Ironwin-15/PLL/Readme.md

Aim and Objective. To design and implement a PLL-assisted adaptive PWM control scheme
for a Buck/Boost converter capable of maintaining a regulated output voltage by dynamically
adjusting the duty cycle through phase synchronization between the output ripple feedback and
an externally generated reference frequency.
