Ironwin-15/PLL/Abstract/(Ishwin_Kumar)_ABSTRACT.pdf

PLL-Based Closed-Loop Buck/Boost Converter | Abstract

### Design and Analysis of a PLL-Based Closed-Loop Buck/Boost DC–DC Converter with Arduino PWM Control

A Stage-by-Stage Mathematical Framework with Hardware Implementation for Regulated 10 V −→ 5 V Conversion

By Ishwin Kumar (Under Prof. Abhilash Patel)

Keywords: Buck converter, PLL, Phase-locked loop, BJT phase detector, BC547A, 555-timer VCO, Arduino PWM, Closed-loop control, Frequency response, Lead compensator, Voltage regulator

Aim and Objective. To design and implement a PLL-assisted adaptive PWM control scheme for a Buck/Boost converter capable of maintaining a regulated output voltage by dynamically adjusting the duty cycle through phase synchronization between the output ripple feedback and an externally generated reference frequency.

Background and Motivation. Efficient and regulated DC–DC power conversion is a foundational requirement in embedded systems, battery-powered devices, and laboratory power supplies. Conventional open-loop buck converters suffer from output-voltage drift under varying load and line conditions, motivating the need for a robust closed-loop architecture. This work presents the complete design, hardware implementation, and mathematical analysis of a Phase-Locked Loop (PLL)-based buck/boost converter that regulates an input supply of Vin = 10 V to a stable output of Vout = 5 V, delivering a 50% step-down with tight voltage regulation across load transients.

System Architecture. The proposed system integrates six functional stages into a coherent closed-loop topology. The power stage is an N-channel MOSFET-switched buck (or boost) converter driven by a PWM gate signal of duty cycle D = Vout/Vin. The output is sensed through a resistive divider (R1–R2), scaled to a feedback voltage Vfb = Vout ·R2/(R1 +R2). An AC coupling capacitor extracts the switching-ripple component and feeds it to the phase detector, which compares it against the Arduino-generated reference fref . The phase-error voltage VP D = KP D ϕerr drives the VCO, whose output fV CO = f0 + KV CO Vctrl is compared with a sawtooth ramp inside a comparator, producing the PWM signal that closes the loop.

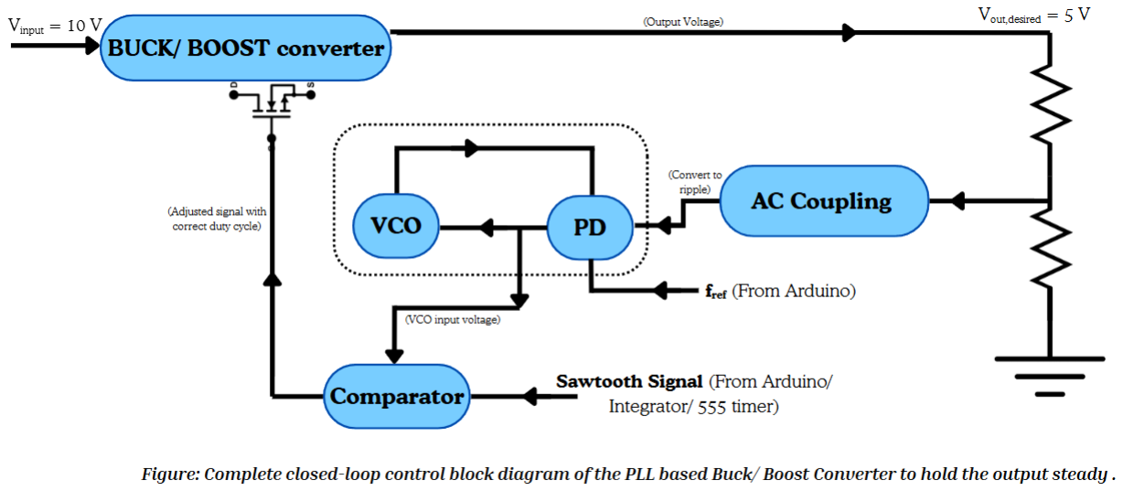
[picture p1: figure]

Figure 1. System Architecture Block Diagram

Work Completed. The following tasks have been completed and are documented with full symbolic derivations and hardware measurements.
(i) PLL Hardware Implementation. The PLL has been fully constructed in hardware. The phase detector is implemented using a BJT-based differential mixer circuit built around the BC547A NPN transistor, whose output is buffered before being fed to the next stage. The VCO is designed around a 555-timer-inspired topology, producing a variable output frequency of up to approximately 500 Hz in response to the PD control voltage. The hardware PD characteristic (output voltage vs. phase difference in degrees) has been measured and curvefitted using Desmos, yielding the sinusoidal regression:
VP D(ϕ) = A sin(Bϕ + C) + D, | A = 1.725, B = 1.058, C = −1.689, D = 2.444, | R² = 0.985

The VCO frequency-vs-voltage characteristic has been measured and confirms excellent linearity, with the linear regression f = m Vctrl + b giving m = 450.25 Hz/V and b = −6.61, R² = 0.998 — establishing the hardware VCO gain as KV CO = 450.25 Hz/V.
(ii) Closed-Loop PLL Analysis and Compensator Design. The complete open-loop transfer function GOL(s) = KP D KV CO F(s)/s has been formulated and analysed using frequency response methods (Bode plots). Natural frequency ωn =

p
KP D KV CO/(RLF CLF ) and damping ratio ζ =

1/2 p
KP D KV CO RLF /CLF were derived and tuned to achieve optimal lock range, pull-in range, and lock time. A compensator has been designed for the loop to meet the required phase margin (≥45) and loop bandwidth (fc ≈ fsw/10), ensuring stable and fast acquisition of lock.
(iii) Buck Converter Design. The basic buck converter stage has been designed to output Vout = 5 V from Vin = 10 V at D = 0.5, with appropriate component sizing and a switching frequency of fsw = 5 kHz via Arduino Timer 1 (ICR1 = 511, OCR1A = 256). The feedback mechanism connecting the PLL output to the MOSFET gate driver — completing the full closed-loop regulation — is not yet implemented and constitutes the primary remaining deliverable.

Experimental Results. Figures 2a and 2b show the hardware characterisation data measured from the built circuit and plotted in Desmos. Figure 2a presents the PD output voltage as a function of input phase difference (in units of radians), with the sinusoidal regression confirming the theoretical KP D ≈ VDD/2π = 1.902 V/rad in theory and matching the fitted amplitude A = 1.725 V. Figure 2b presents the VCO output frequency (Hz) vs. control voltage (V), demonstrating the highly linear KV CO = 450.25 Hz/V characteristic required for predictable PLL behaviour.

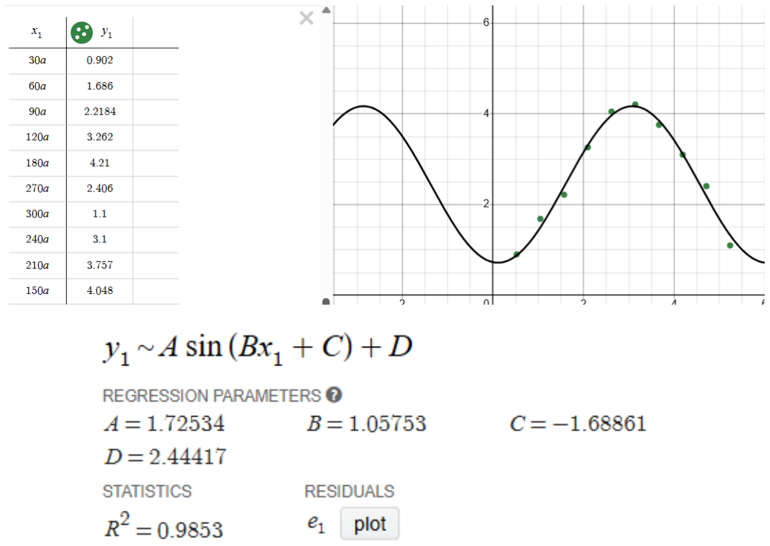
[picture p2: figure]

(a) PD hardware output: VPD vs. phase difference. Fitted curve yields R² = 0.985, KPD = 1.7253 V/rad via sinusoidal fit.

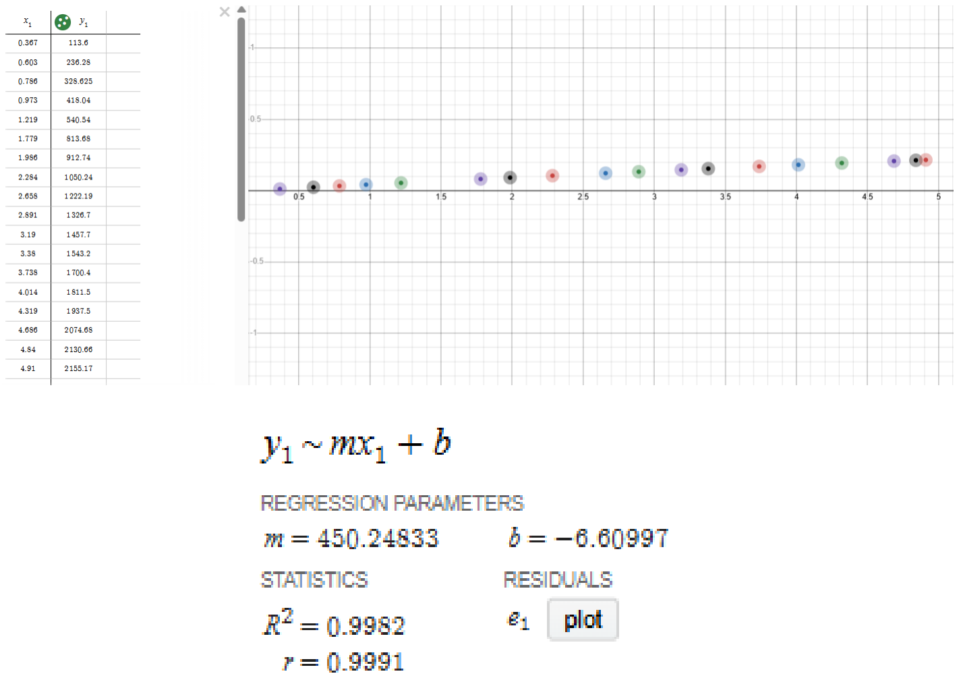
[picture p3: figure]

(b) VCO hardware output: Frequency vs. Vctrl. Fitted curve yields KV CO = 450.25 Hz/V,
f = 450.25V − 6.61, R² = 0.998 via linear fit.

Figure 2. Hardware characterisation plots obtained from the built BC547A phase detector and 555-timer VCO circuit. All regressions were performed in Desmos.

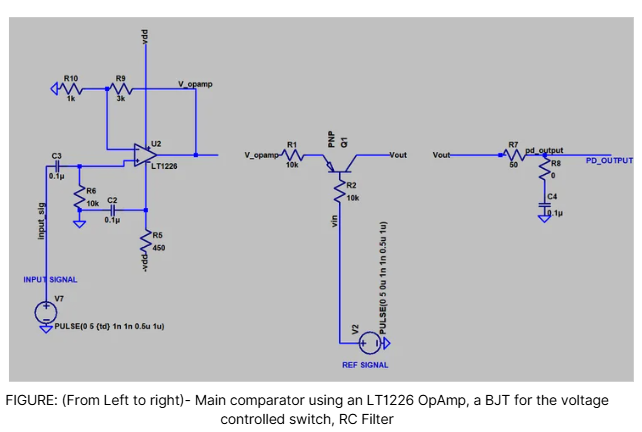
[picture p4: figure]

(a) Phase detector schematic circuit using Bipolar Junction Transistor.

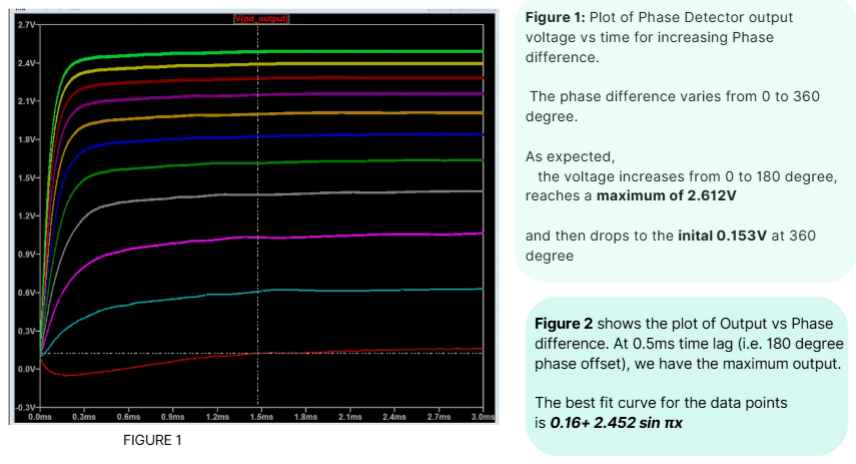
[picture p5: figure]

(b) Phase detector simulated output voltage response vs. increasing phase difference.

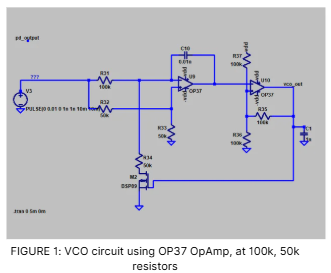
[picture p6: figure]

(a) VCO schematic model and verification using an OP37 OpAmp configuration.

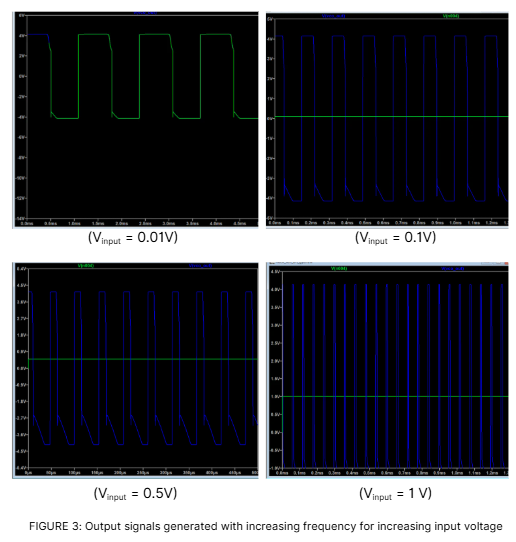
[picture p7: figure]

(b) Increasing output frequencies with increasing input voltage.

Figure 4. LTSpice characterisation plots obtained from the simulated phase detector and VCO circuits.

What This Work Will Demonstrate. The remaining work will close the loop by connecting the PLL output to the buck converter switching MOSFET and demonstrating full closed-loop voltage regulation. Specifically, the following results are targeted: (a) stable Vout = 5.0 ± 0.1 V from 10 V across varying load; (b) oscilloscope verification of D = 50% PWM at the MOSFET gate; (c) PLL lock acquisition waveforms confirming phase detector and VCO hardware operation at the predicted KP D and KV CO values; (d) a completely locked output voltage inspite of fluctuations in the input voltage.

This abstract accompanies the full technical report containing the system block diagram, complete design summary, key waveform plots, compensator design progress, and annotated Arduino firmware. All numerical values correspond to Vin = 10 V, Vout = 5 V, Iout ≤ 1 A, fsw = 5 kHz.
