Ironwin-15/PLL/Boost_Converter/500Hz_output.png

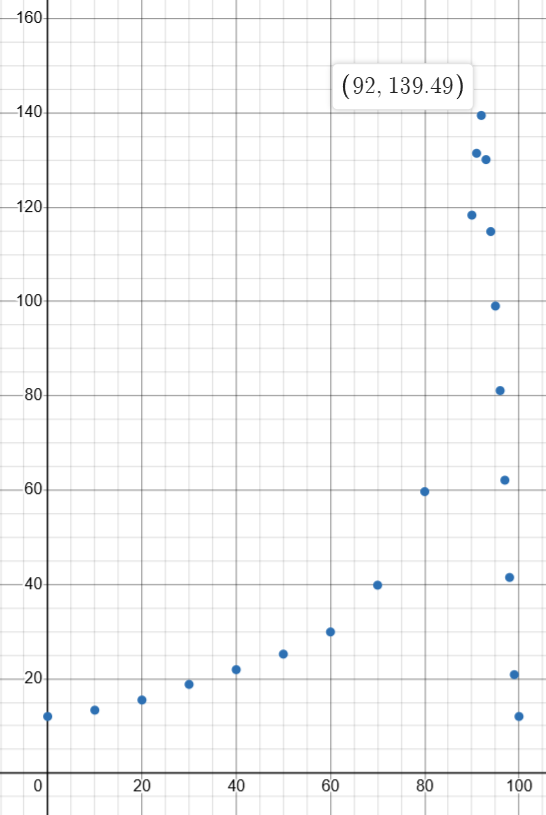
Boost_Converter/500Hz_output.png
