Ironwin-15/PLL/Boost_Converter/COMPENSATED_PLL .png

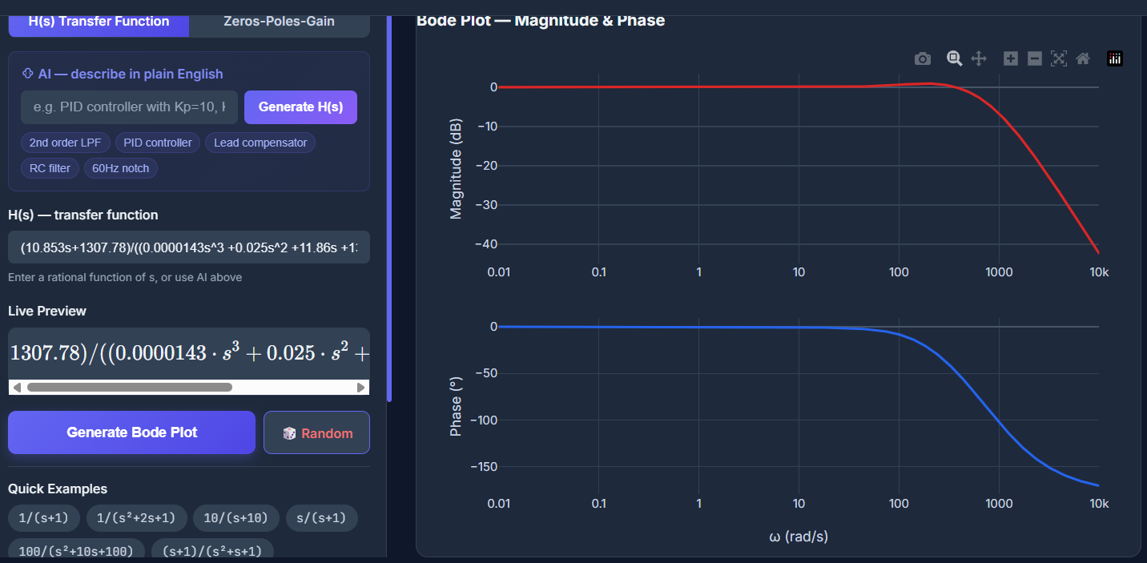
Boost_Converter/COMPENSATED_PLL .png
