Ironwin-15/PLL/Boost_Converter/Phase margin = 128.6.png

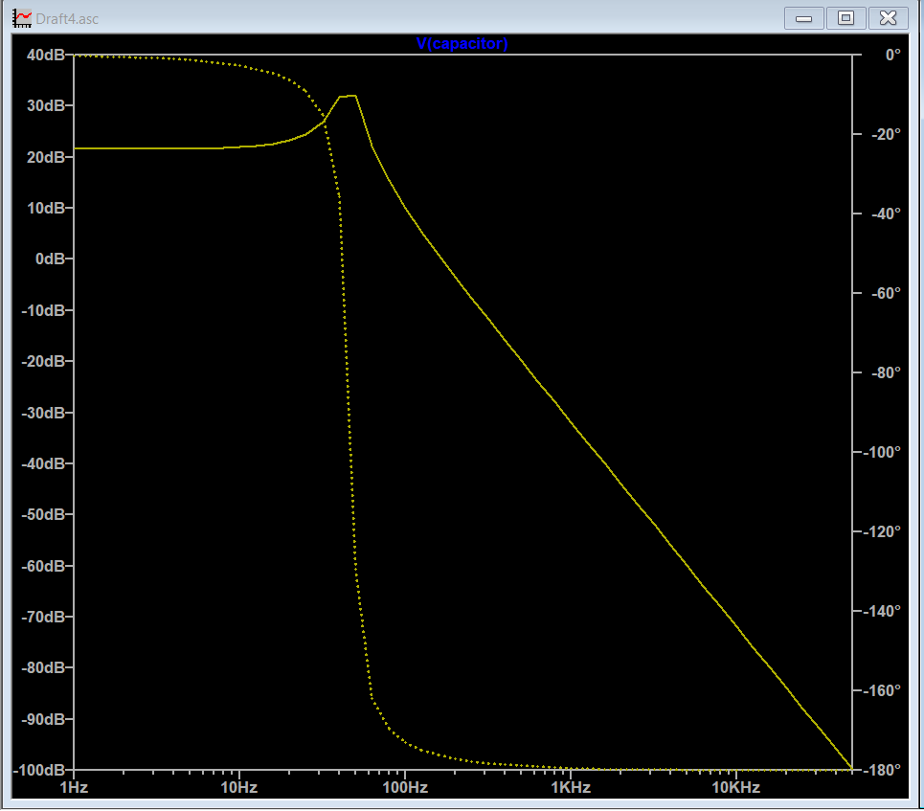
Boost_Converter/Phase margin = 128.6.png
