Ironwin-15/PLL/Boost_Converter/PM=-45) UNCOMPENSATED_BOOST+PLL.png

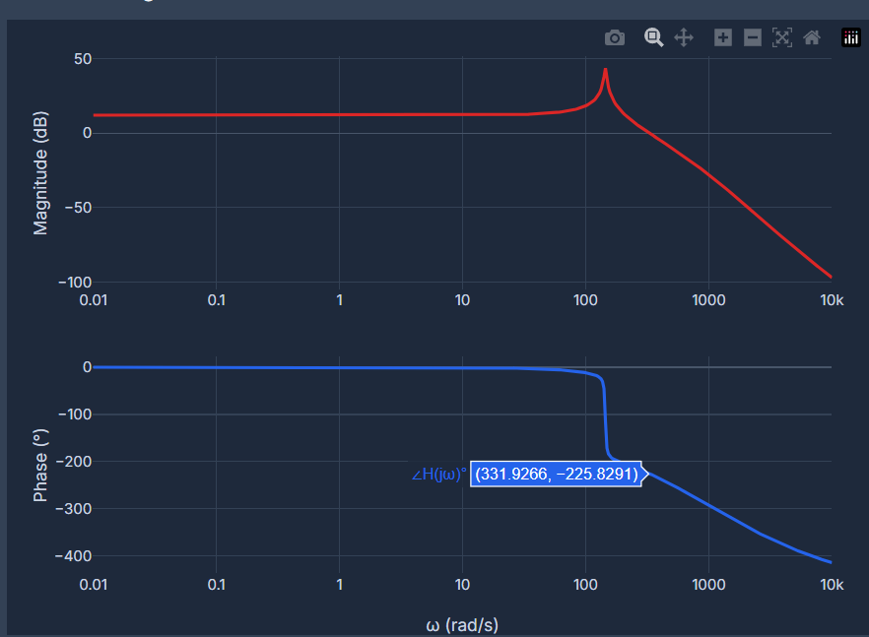
Boost_Converter/PM=-45) UNCOMPENSATED_BOOST+PLL.png
