Ironwin-15/PLL/Boost_Converter/Screenshot 2026-06-19 024352.png

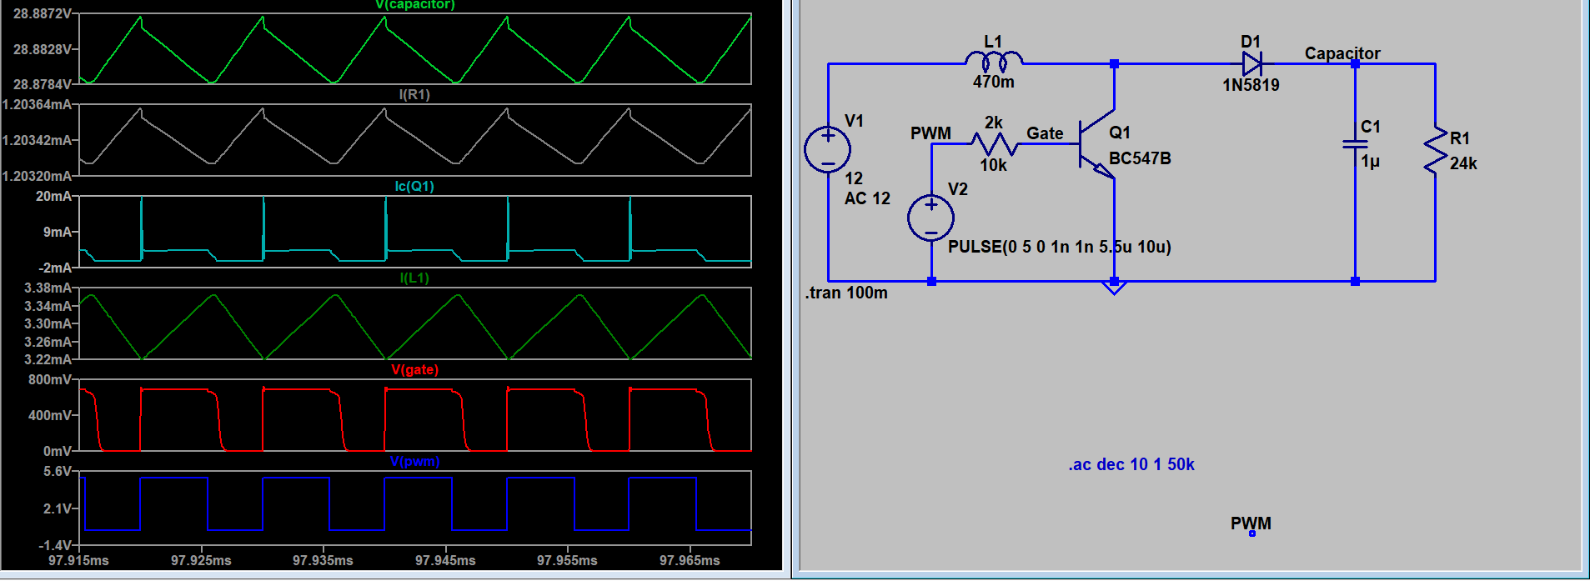
Boost_Converter/Screenshot 2026-06-19 024352.png
