Ironwin-15/PLL/Boost_Converter/theoretical values.png

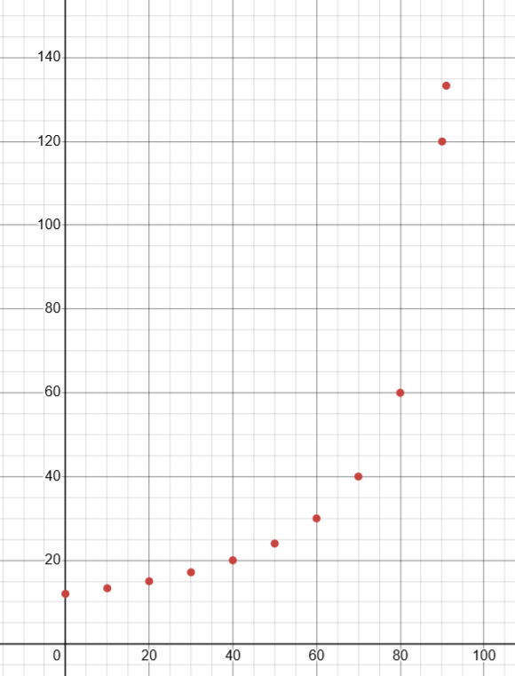
Boost_Converter/theoretical values.png
