Ironwin-15/PLL/Op_Amp Design/Circuit_implementation_of_Phasedetector.png

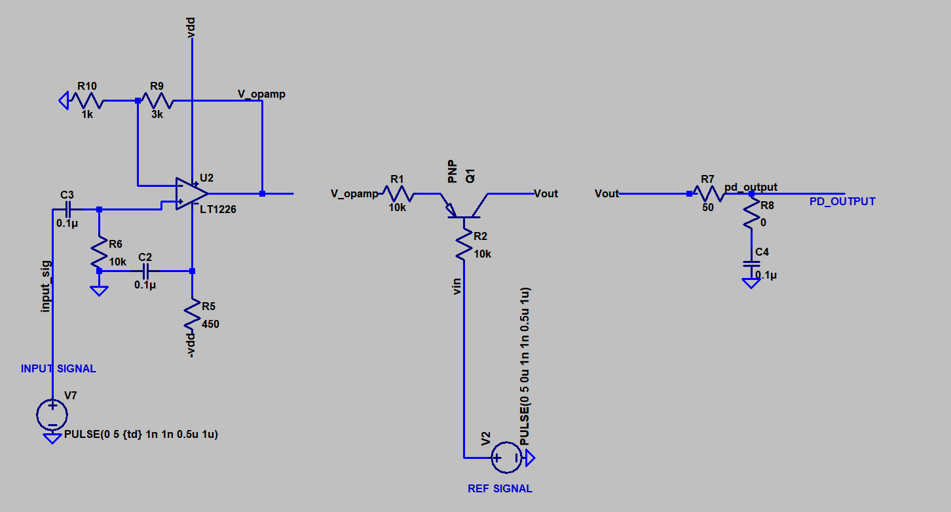
Op_Amp Design/Circuit_implementation_of_Phasedetector.png
