Ironwin-15/PLL/Op_Amp Design/Circuit_of_VCO.png

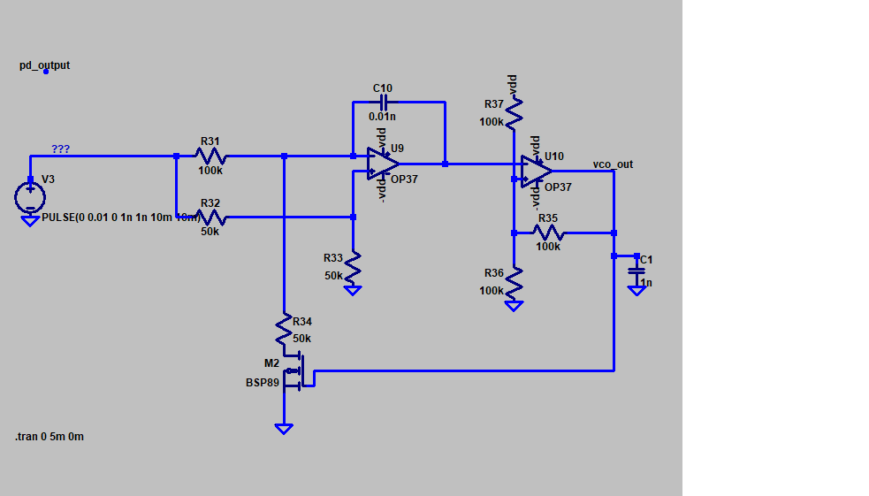
Op_Amp Design/Circuit_of_VCO.png
