Ironwin-15/PLL/Op_Amp Design/Graphs(V_pdout vs timelag)_BJT_SW.png

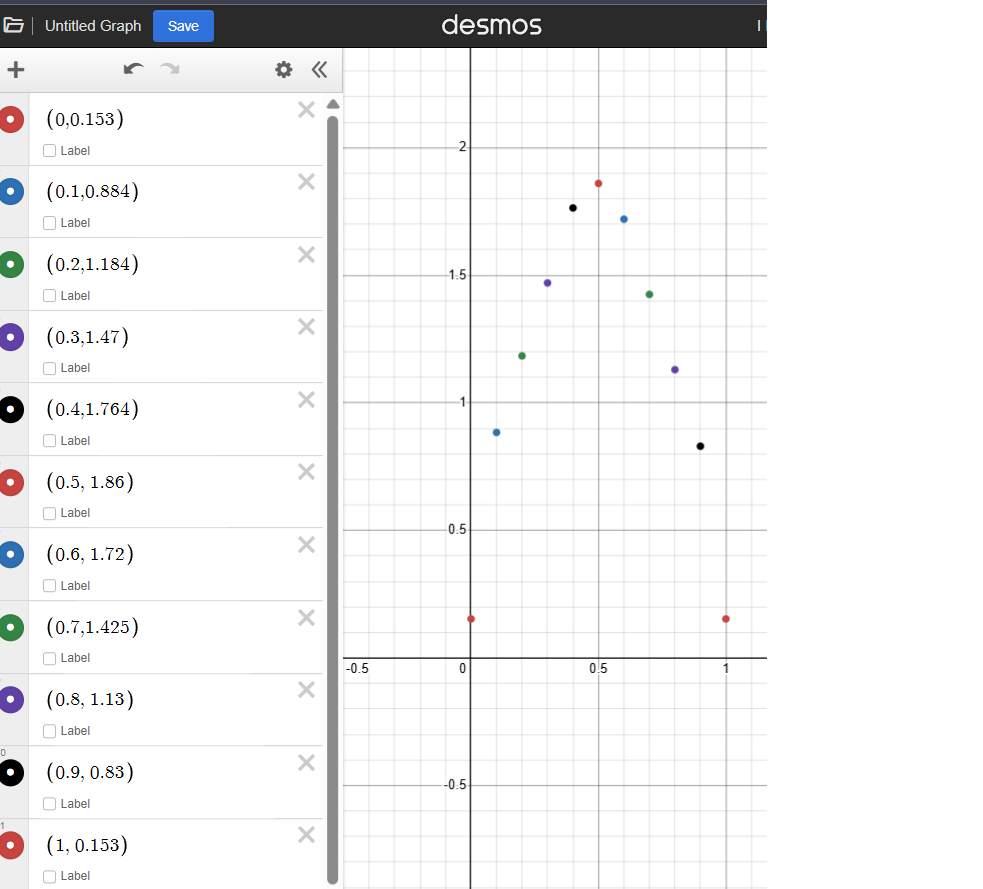
Op_Amp Design/Graphs(V_pdout vs timelag)_BJT_SW.png
