Ironwin-15/PLL/Op_Amp Design/loop_filter.png

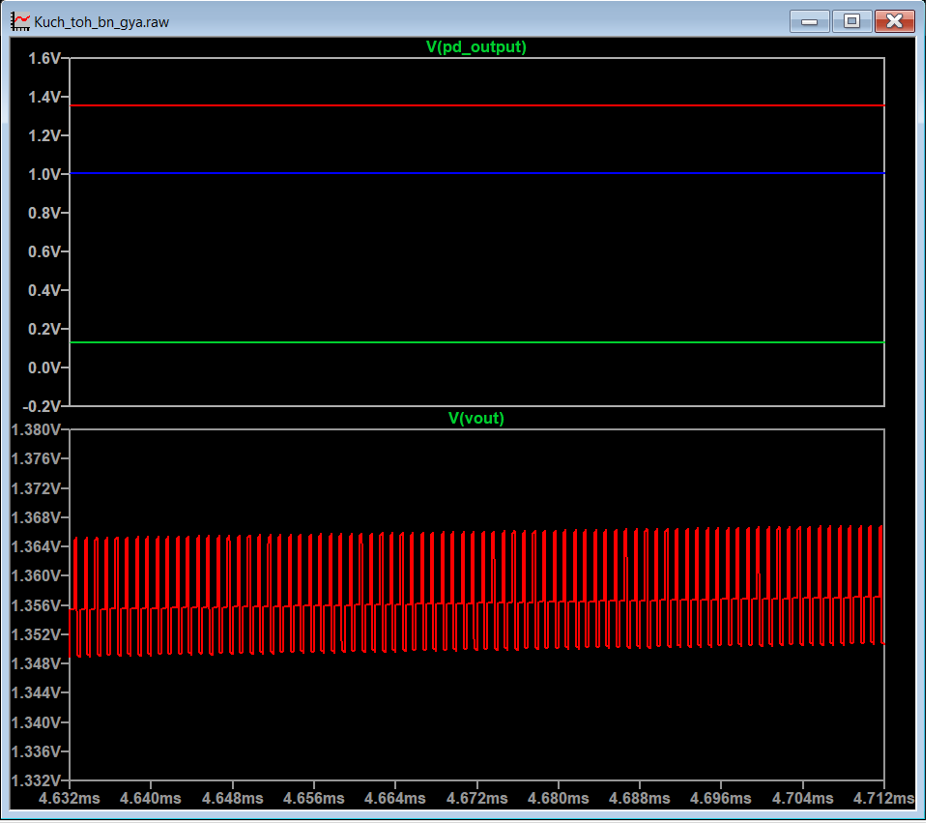
Op_Amp Design/loop_filter.png
