Ironwin-15/PLL/Op_Amp Design/PD_motivation.gif

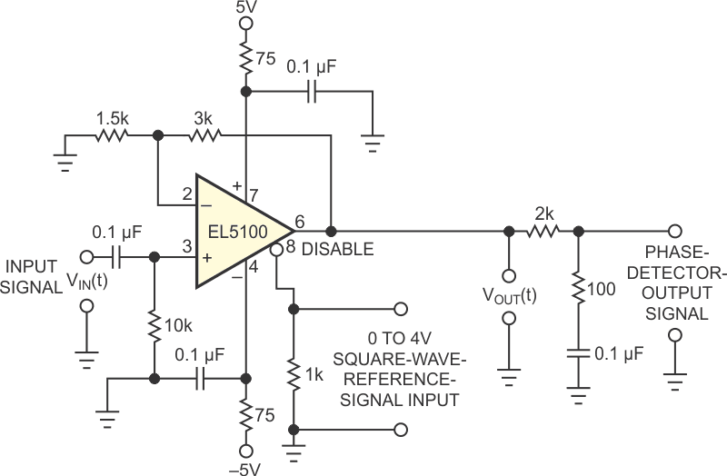
Op_Amp Design/PD_motivation.gif
