Ironwin-15/PLL/Op_Amp Design/pd_output (from time_delay=0u-1u).png

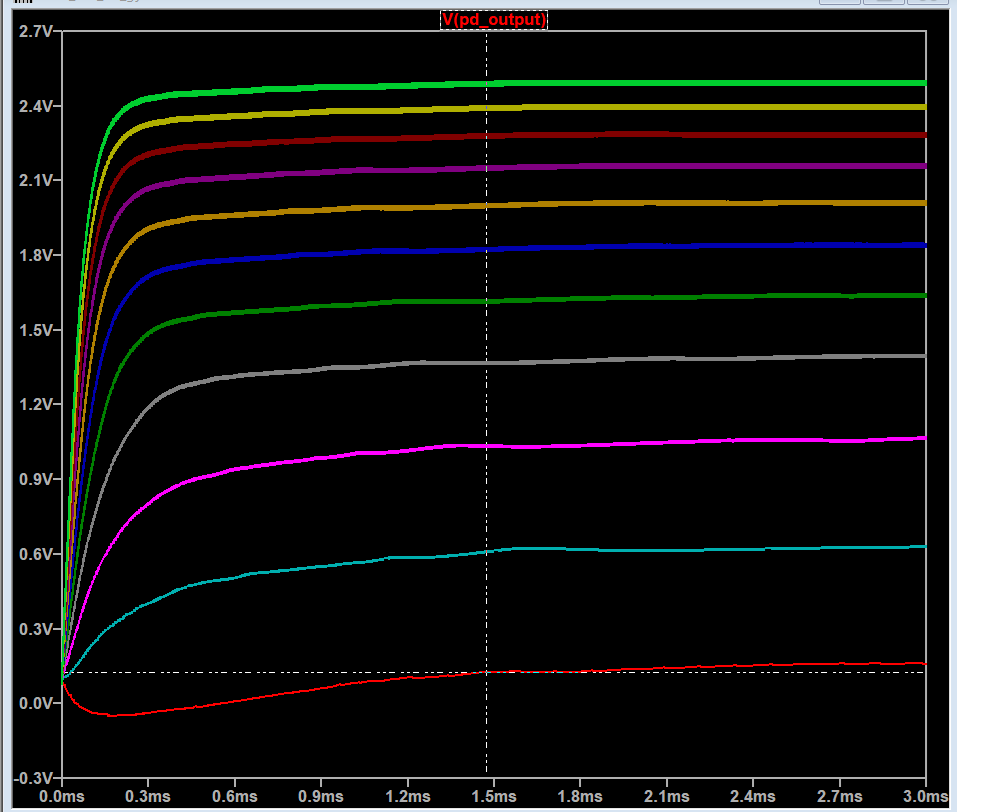
Op_Amp Design/pd_output (from time_delay=0u-1u).png
