Ironwin-15/PLL/Op_Amp Design/VCO output_for_V=0.01V.png

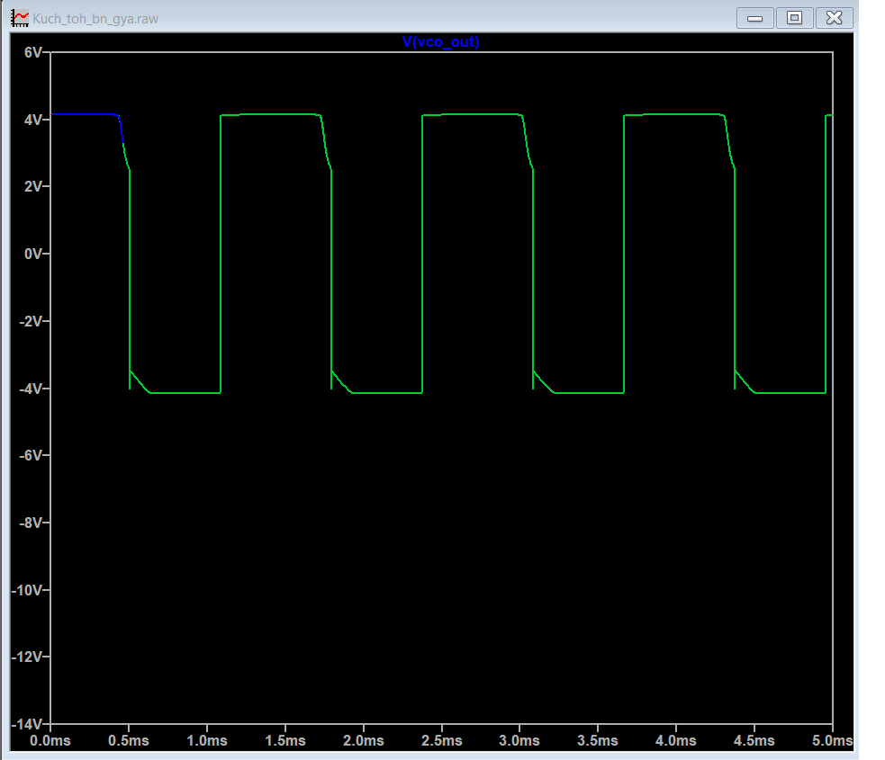
Op_Amp Design/VCO output_for_V=0.01V.png
