Ironwin-15/PLL/Op_Amp Design/VCO output_for_V=1V.png

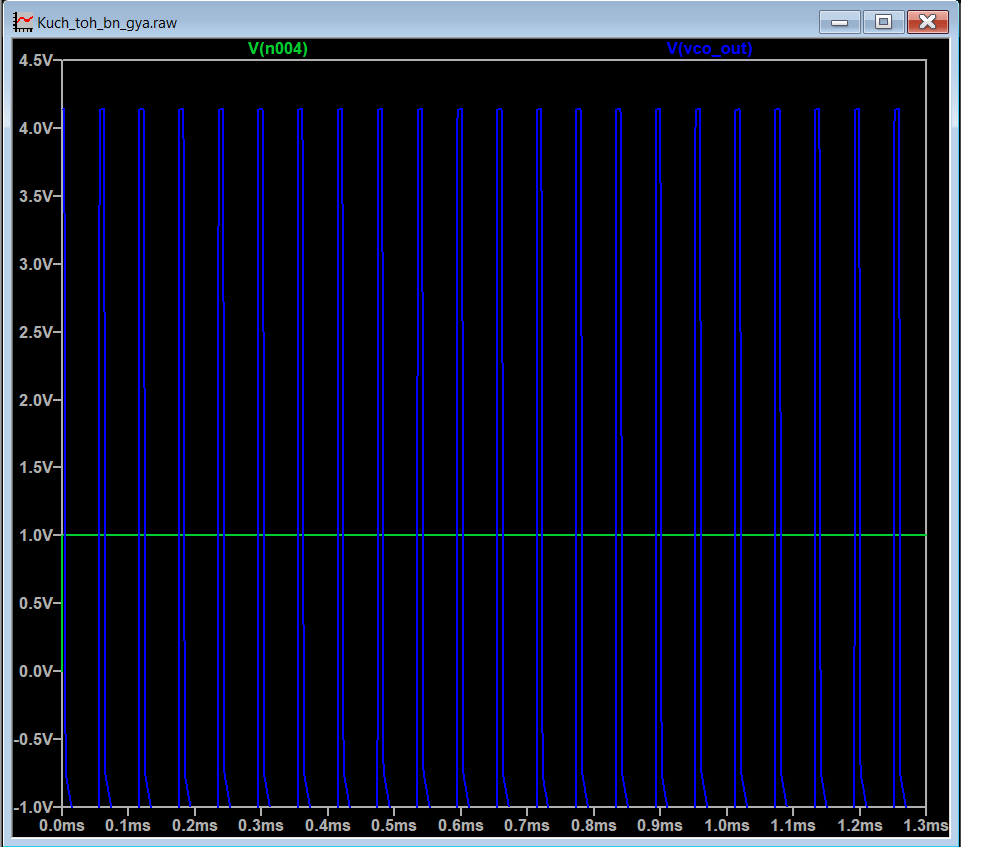
Op_Amp Design/VCO output_for_V=1V.png
