Ironwin-15/PLL/Op_Amp Design/VCO(Freq(in_kHz vs Vin).png

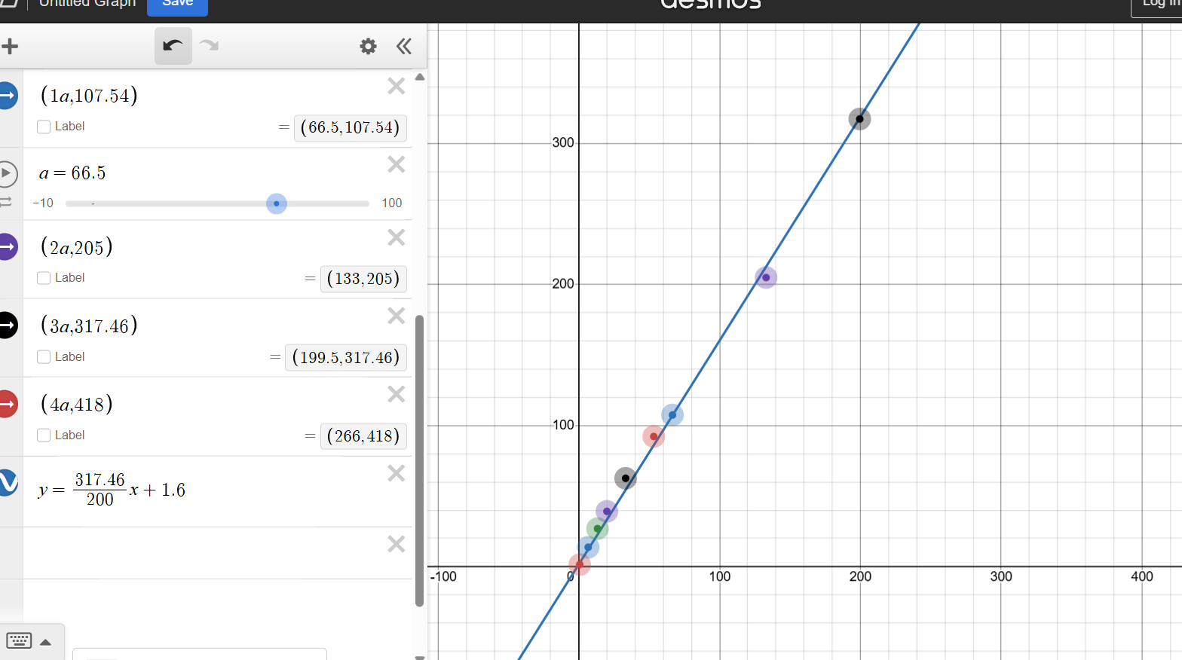
Op_Amp Design/VCO(Freq(in_kHz vs Vin).png
