Ironwin-15/PLL/Op_Amp Design/VCO_calculation_offtime.jpg

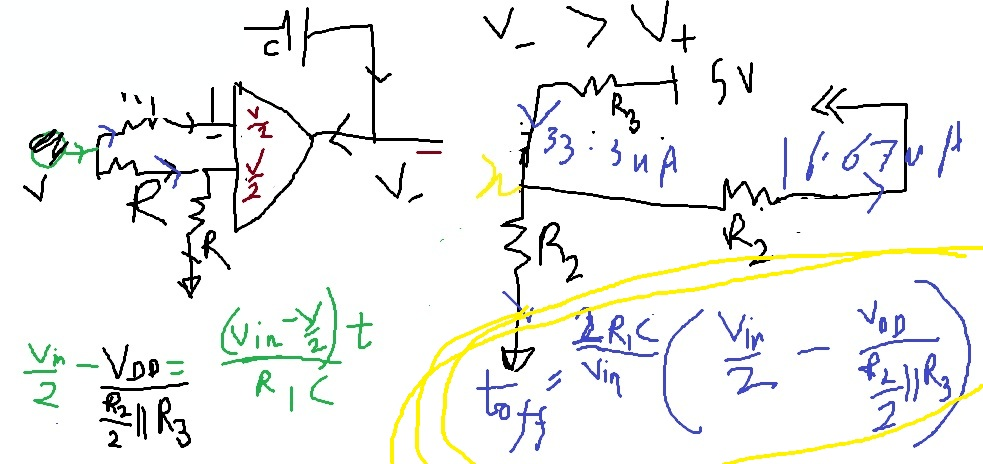
Op_Amp Design/VCO_calculation_offtime.jpg
