Ironwin-15/PLL/Progress Reports/(Ishwin Kumar)_1st_Progress_PPT.pdf

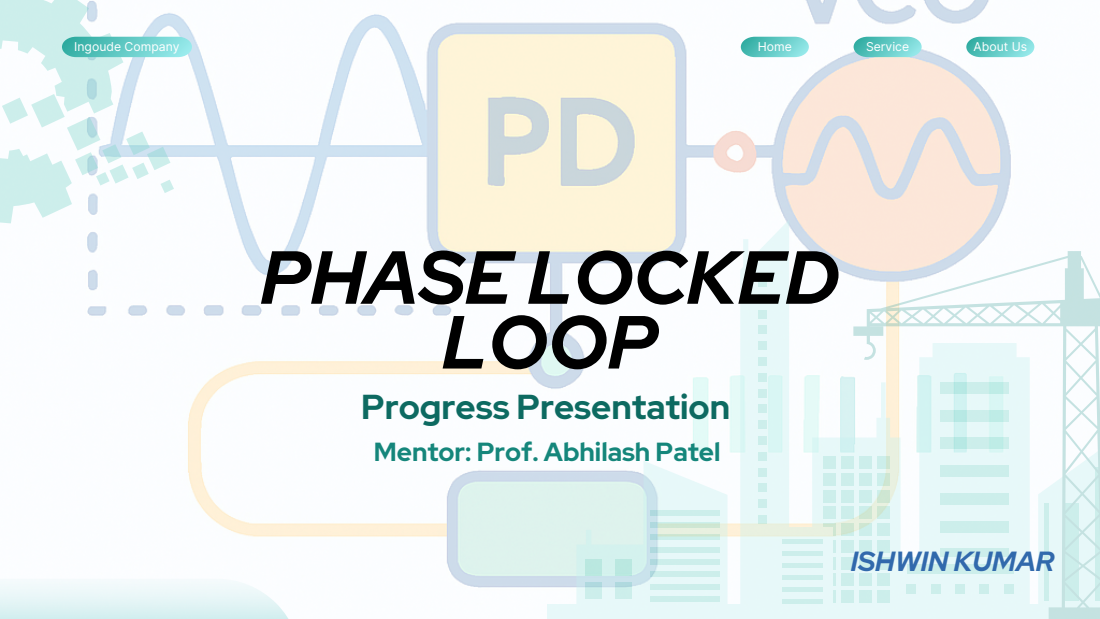
[picture p26: page 1]
PHASE LOCKED LOOP; Ingoude Company; Home; Service; About Us; ISHWIN KUMAR

Progress Presentation
Mentor: Prof. Abhilash Patel

# CONTENT

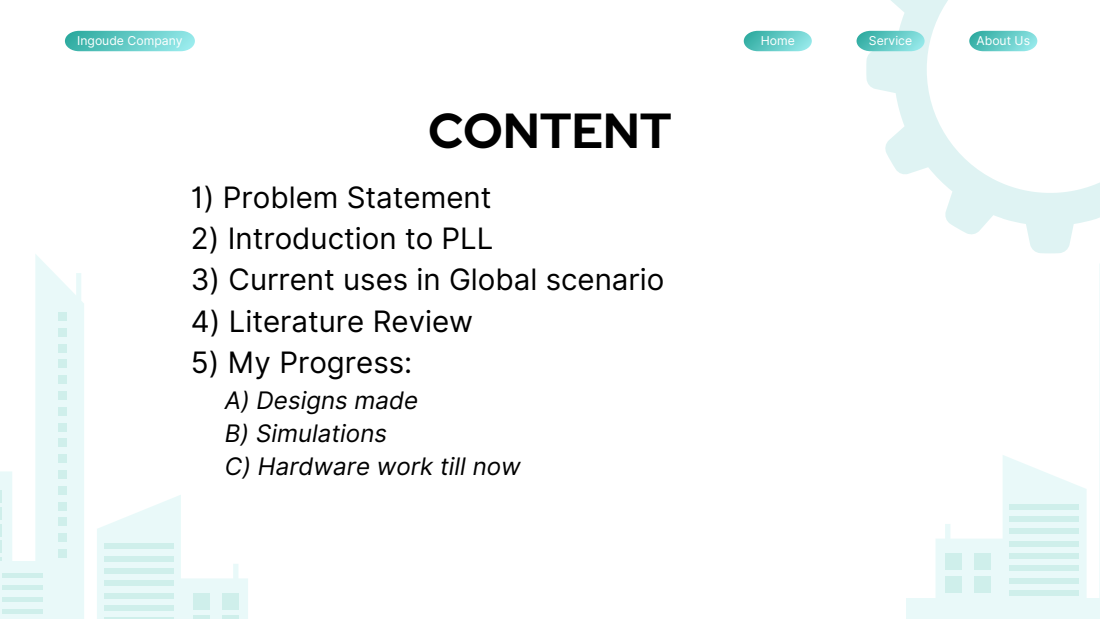
[picture p27: page 2]

1) Problem Statement
2) Introduction to PLL
3) Current uses in Global scenario
4) Literature Review
5) My Progress:
A) Designs made
B) Simulations
C) Hardware work till now

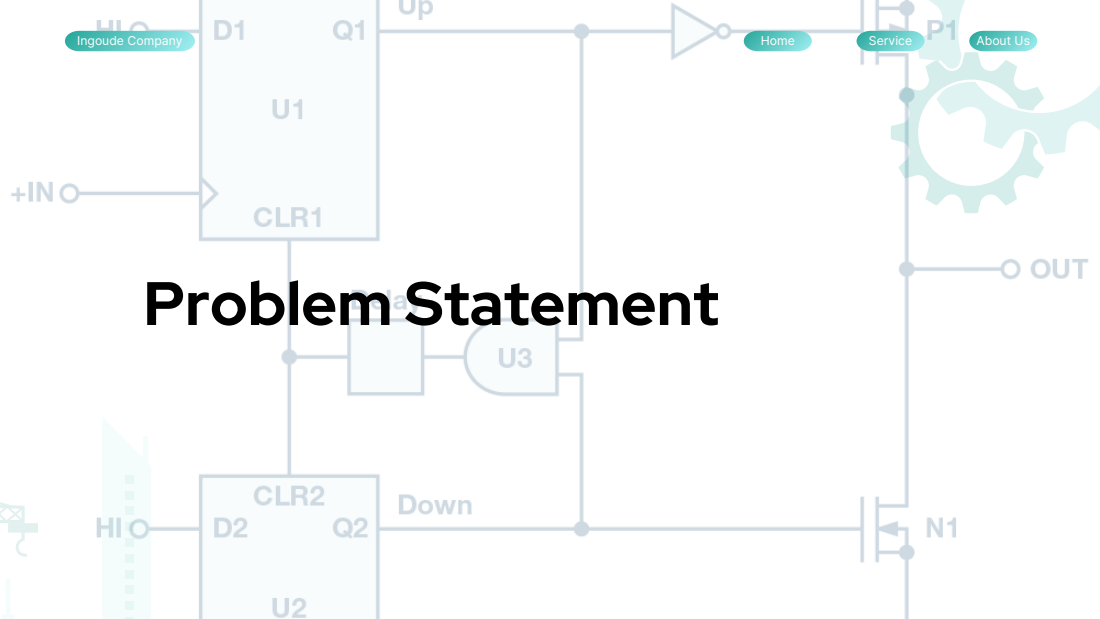
[picture p28: page 3]
Problem Statement

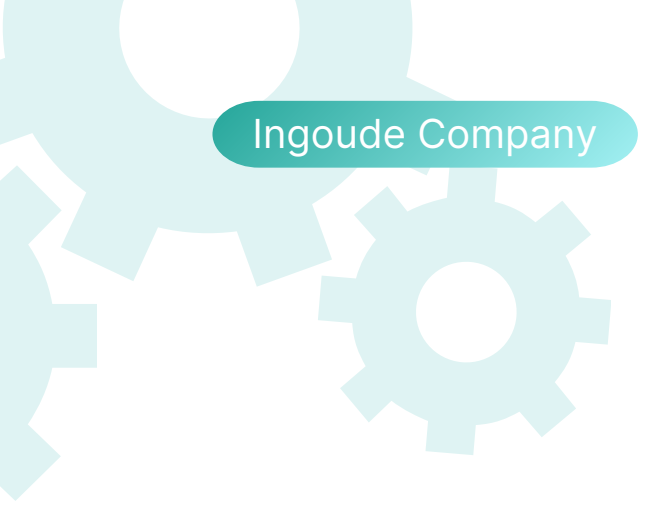
[picture p29: figure]

Design and analyze a second-order Phase-Locked Loop (PLL) by developing its key functional

# blocks and deriving its dynamic model. Determine critical performance parameters such as

natural frequency , damping ratio( ), lock range, lock time, and phase margin, and design an

# appropriate loop compensator to optimize stability of the response and overall system

performance.

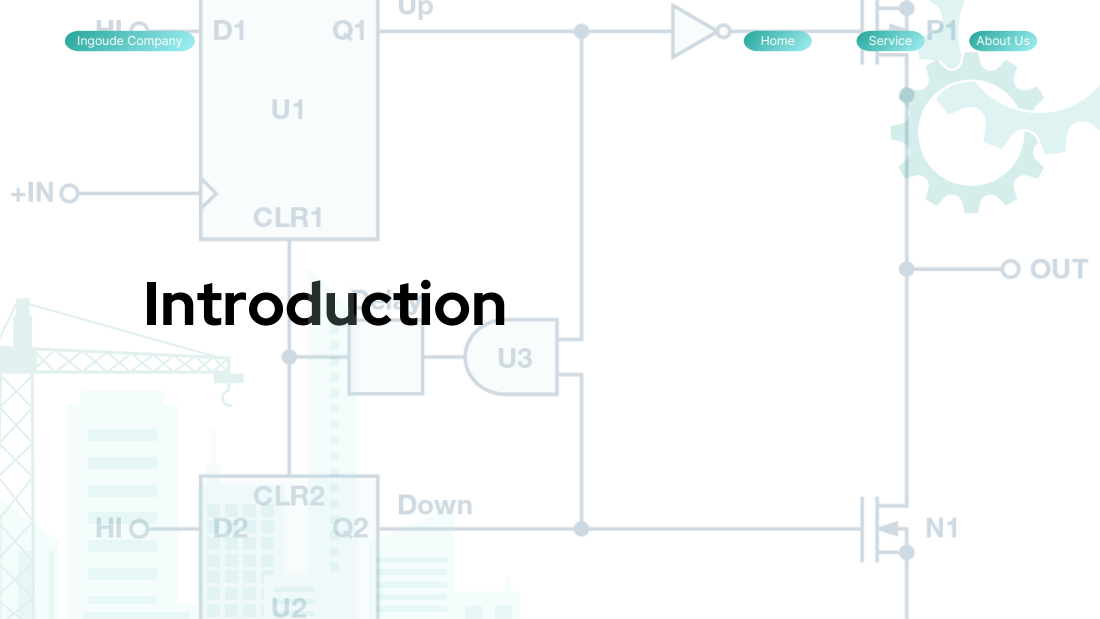
[picture p30: page 5]
Introduction

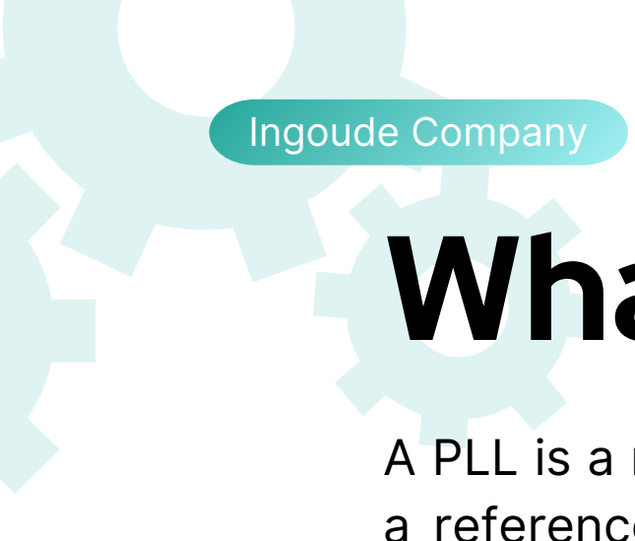
[picture p31: figure]

# What is a Phase Locked Loop?

A PLL is a negative feedback control system which generates an output signal whose phase & frequency is synchronized with a reference input. It enables precise frequency multiplication & duplication generally from a crystal oscillator in general. It continuously compares the phase difference between a reference clock and a feedback clock and adjusts the oscillator until both signals are locked.

### 1) Phase Detector: It is the first stage of the system and is the block that compares the phase of the Reference signal and input signal and generates an error voltage proportional to

the phase difference.

### 2) Loop filter: A simple RC or even an active filter which removes high-frequency components from the phase detector output and generates a DC control voltage

for the VCO.

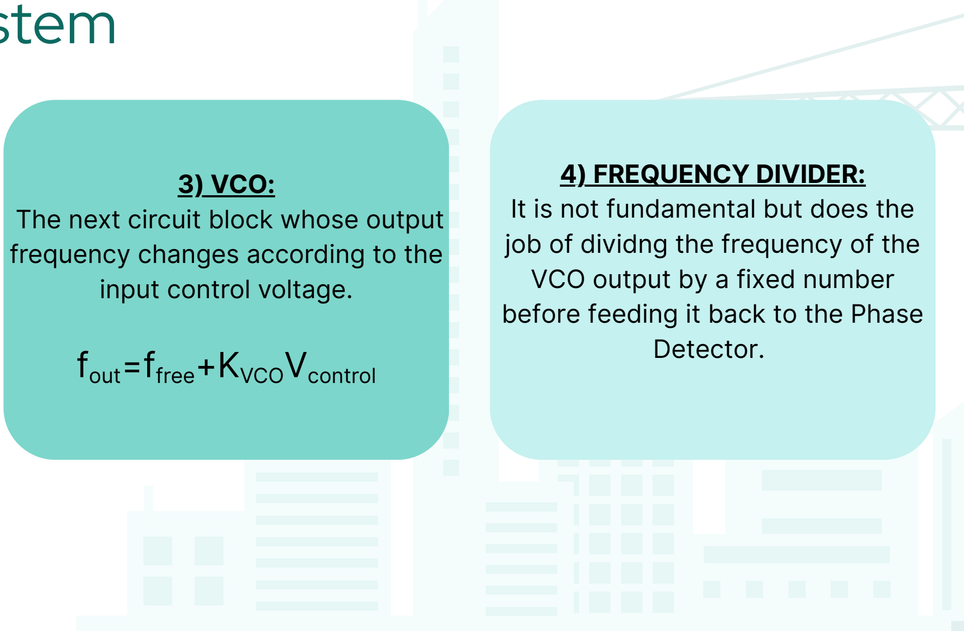
[picture p32: figure]
3) VCO: The next circuit block whose output frequency changes according to the input control voltage.; fout=ffree+KVCOVcontrol; 4) FREQUENCY DIVIDER: It is not fundamental but does the job of dividng the frequency of the VCO output by a fixed number before feeding it back to the Phase Detector.

# The Building Blocks of the system

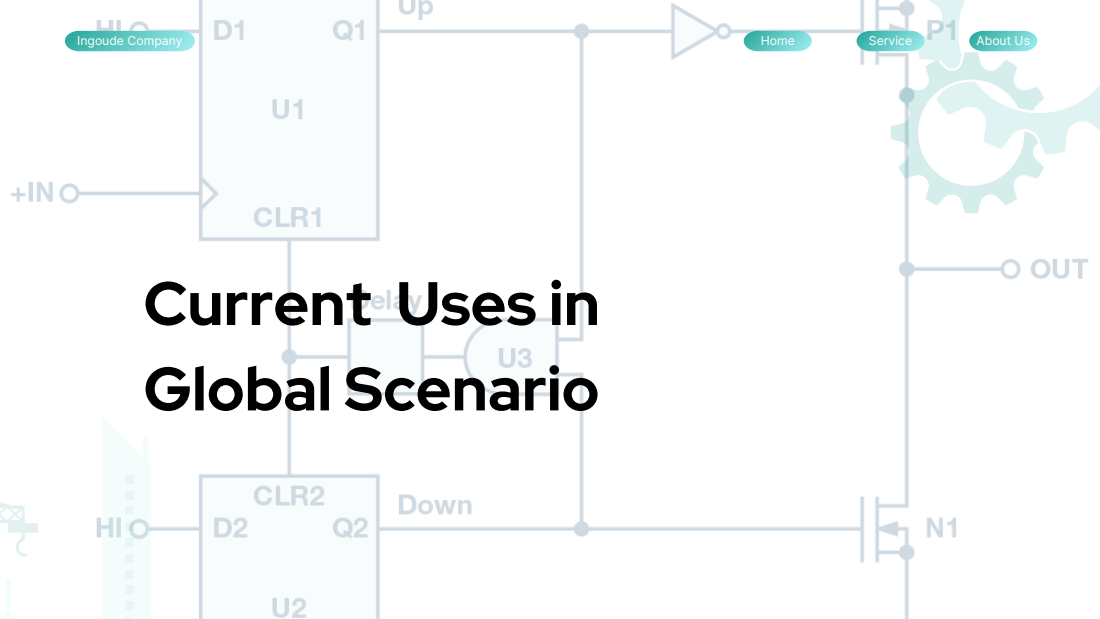
[picture p33: page 7]

Current Uses in
Global Scenario

## Power Grid Synchronization:

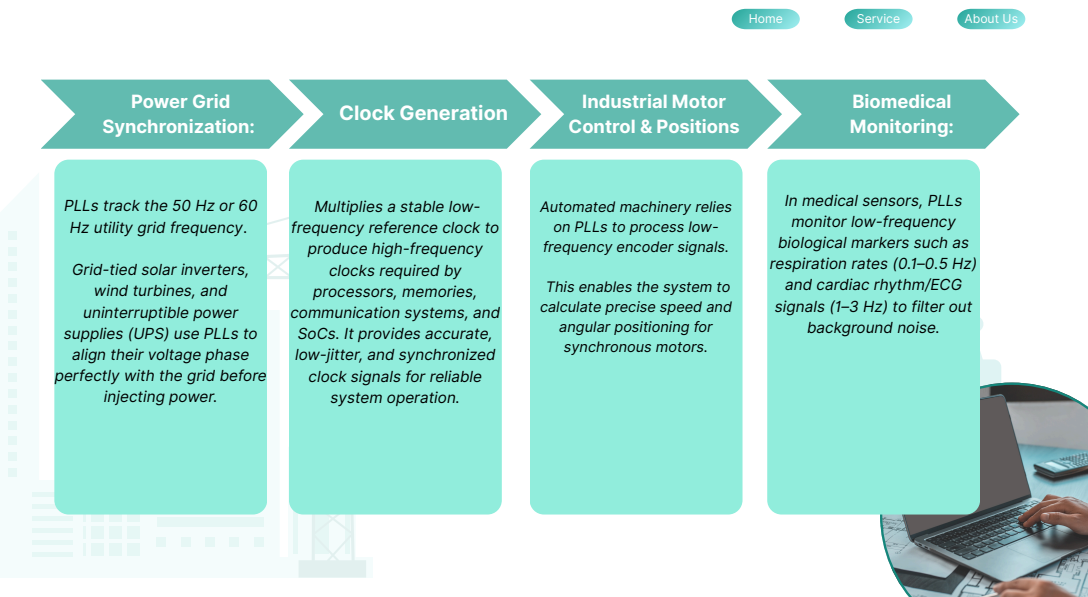
[picture p34: page 8]
Home; Service; About Us; Clock Generation; Biomedical Monitoring:; Industrial Motor Control & Positions

In medical sensors, PLLs
monitor low-frequency
biological markers such as
respiration rates (0.1–0.5 Hz)
and cardiac rhythm/ECG
signals (1–3 Hz) to filter out
background noise.

PLLs track the 50 Hz or 60
Hz utility grid frequency.

Multiplies a stable low-
frequency reference clock to
produce high-frequency
clocks required by
processors, memories,
communication systems, and
SoCs. It provides accurate,
low-jitter, and synchronized
clock signals for reliable
system operation.

Automated machinery relies
on PLLs to process low-
frequency encoder signals.

Grid-tied solar inverters,
wind turbines, and
uninterruptible power
supplies (UPS) use PLLs to
align their voltage phase
perfectly with the grid before
injecting power.

This enables the system to
calculate precise speed and
angular positioning for
synchronous motors.

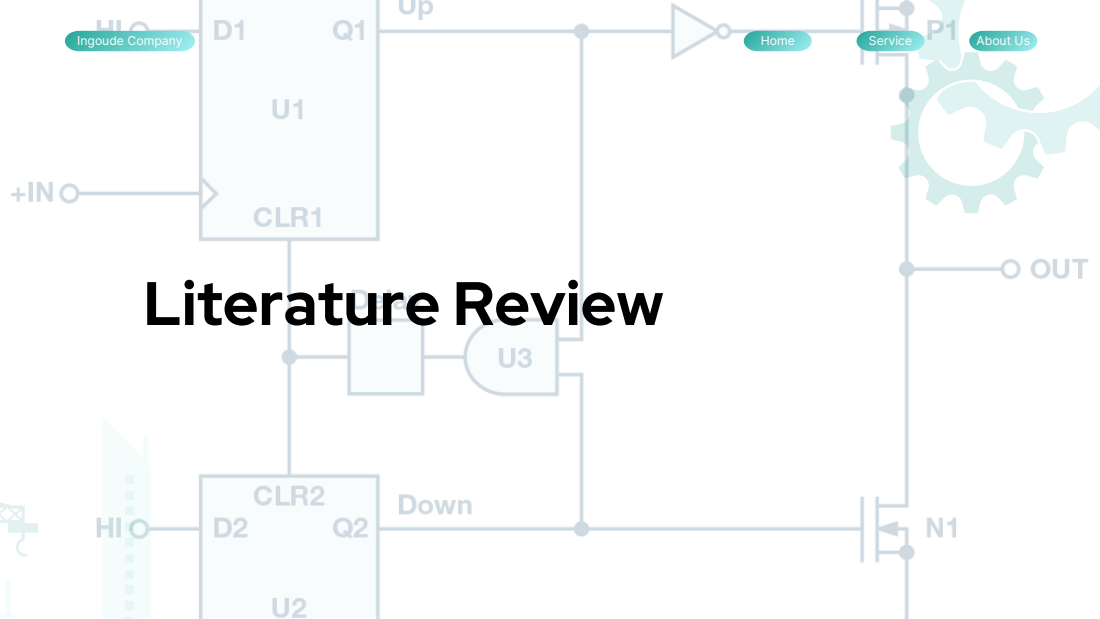
[picture p35: page 9]
Literature Review

The linearized PLL model considered consists of a phase detector,

## loop filter, and voltage controlled oscillator (VCO) connected in a negative

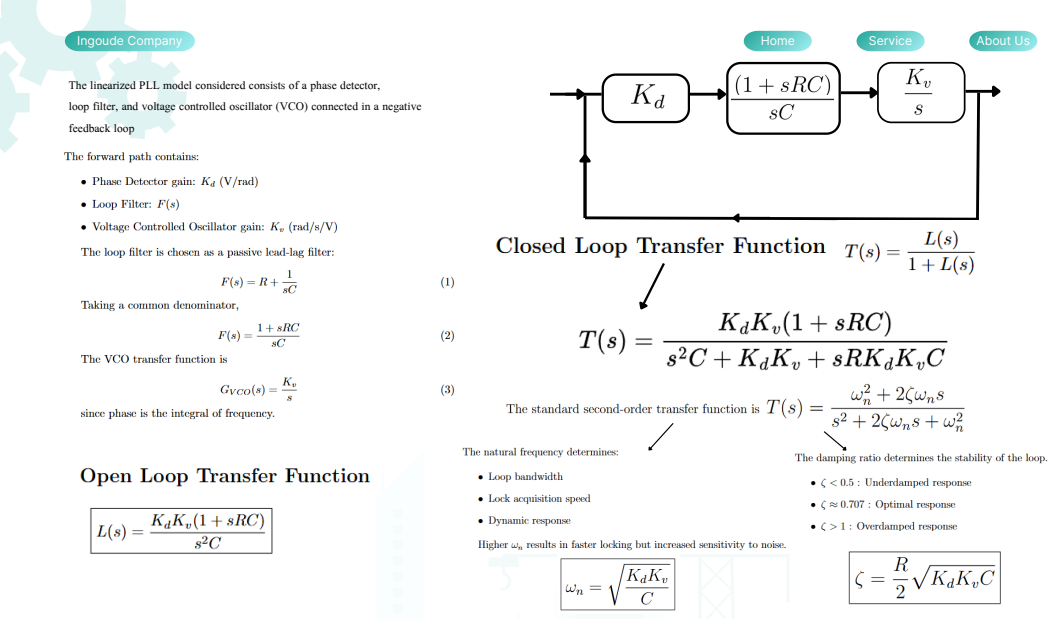
[picture p36: page 10]
feedback loop

# PLL Parameters

# Bode Plots

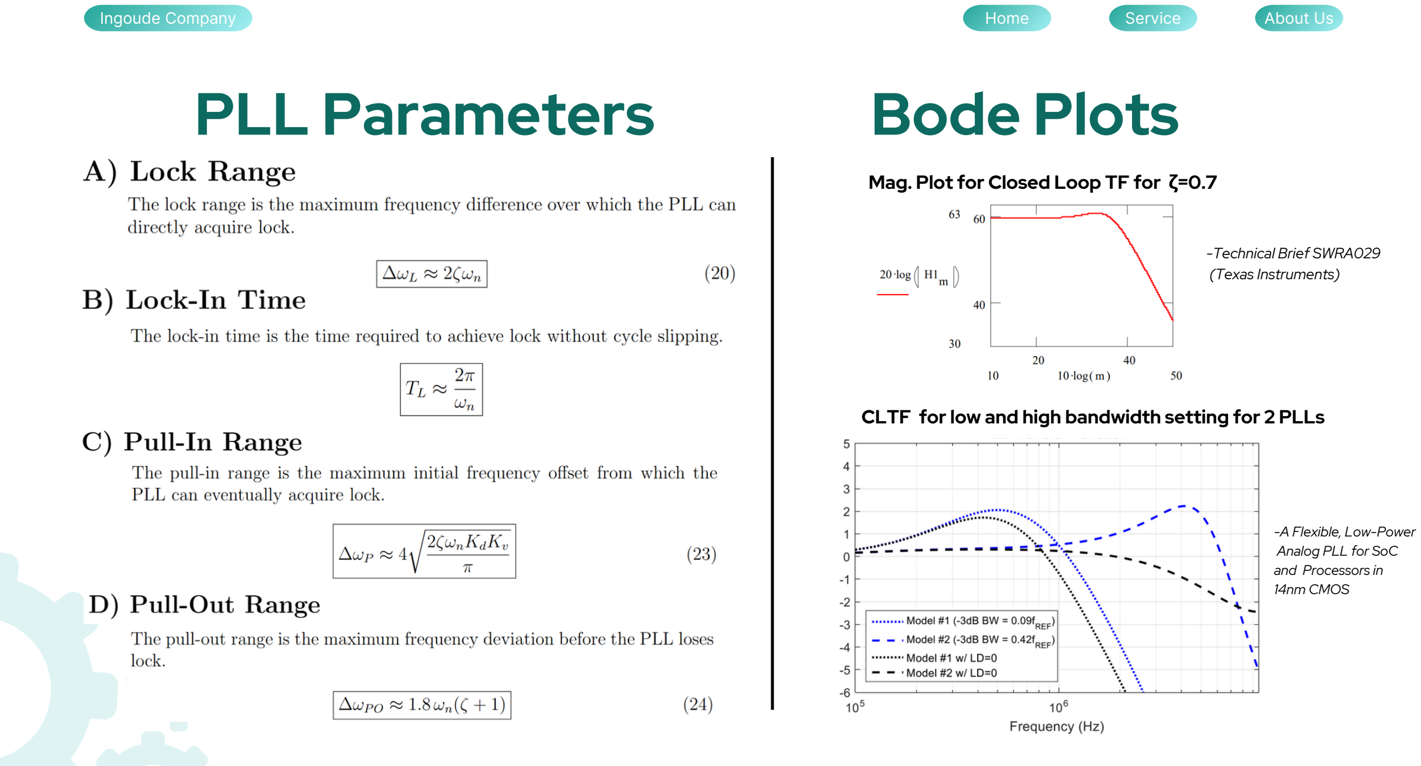
[picture p37: page 11]

### Mag. Plot for Closed Loop TF for ζ=0.7

-Technical Brief SWRA029
(Texas Instruments)

-A Flexible, Low-Power
Analog PLL for SoC
and Processors in
14nm CMOS

### CLTF for low and high bandwidth setting for 2 PLLs

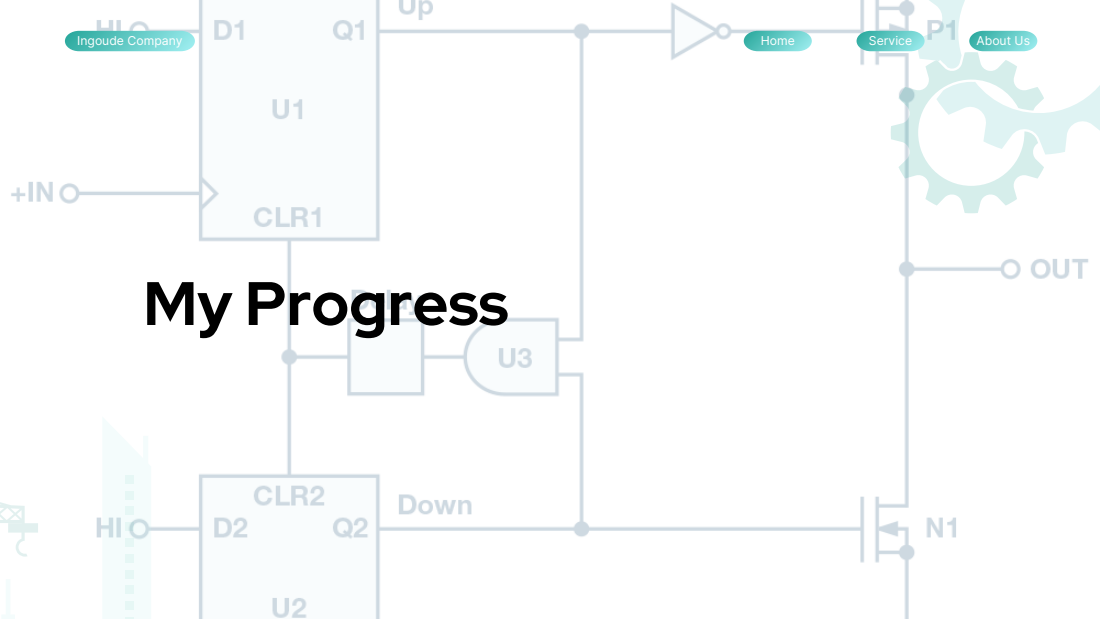
[picture p38: page 12]
My Progress

## As an initial implementation, an XOR-based phase detector was selected which receives the

reference signal and the input signal and then compares the phase between these signals using a very simple boolean logic and generates an output waveform whose duty cycle is proportional to the phase difference between them.

When signals are perfectly in phase, output remains low, i.e. a duty cycle of 0%.

When signals are exactly out of phase, output corresponds to a duty cycle of 100%.

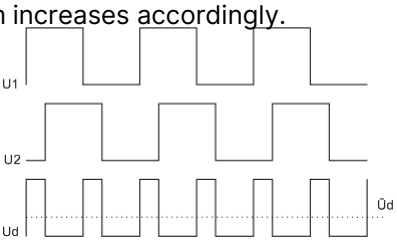
[picture p39: figure]

As the phase difference increases, the pulse width of the output waveform increases accordingly.

# Designs Using MOSFETS

# 1) THE XOR GATE DESIGN

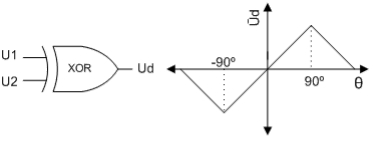
[picture p40: figure]

# XOR Gate Design (Contd..)

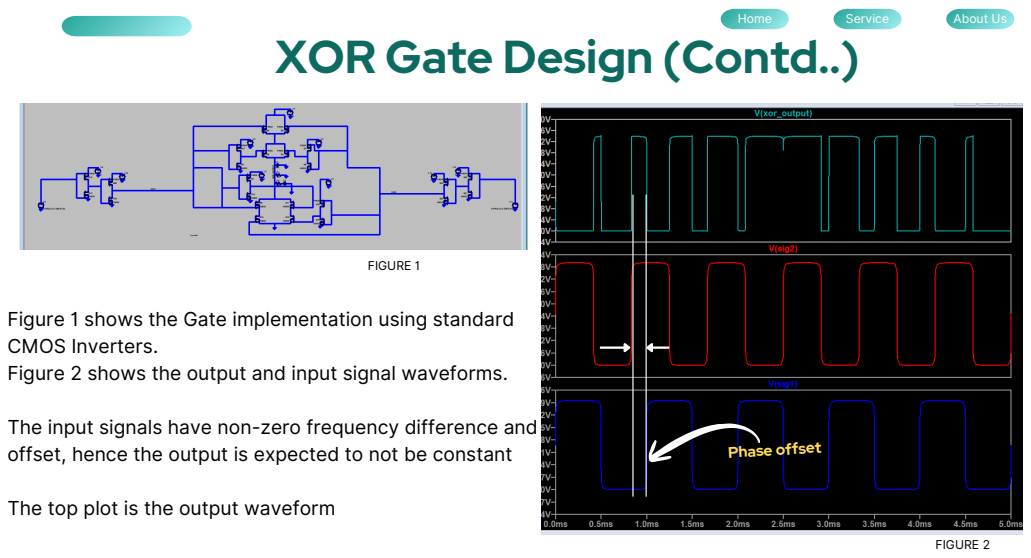
[picture p41: page 14]
FIGURE 1; Home; Service; About Us; FIGURE 2; Phase offset

Figure 1 shows the Gate implementation using standard
CMOS Inverters.
Figure 2 shows the output and input signal waveforms.

The input signals have non-zero frequency difference and
offset, hence the output is expected to not be constant

The top plot is the output waveform

# Designs Using MOSFETS

# 2) Using Flip Flops-

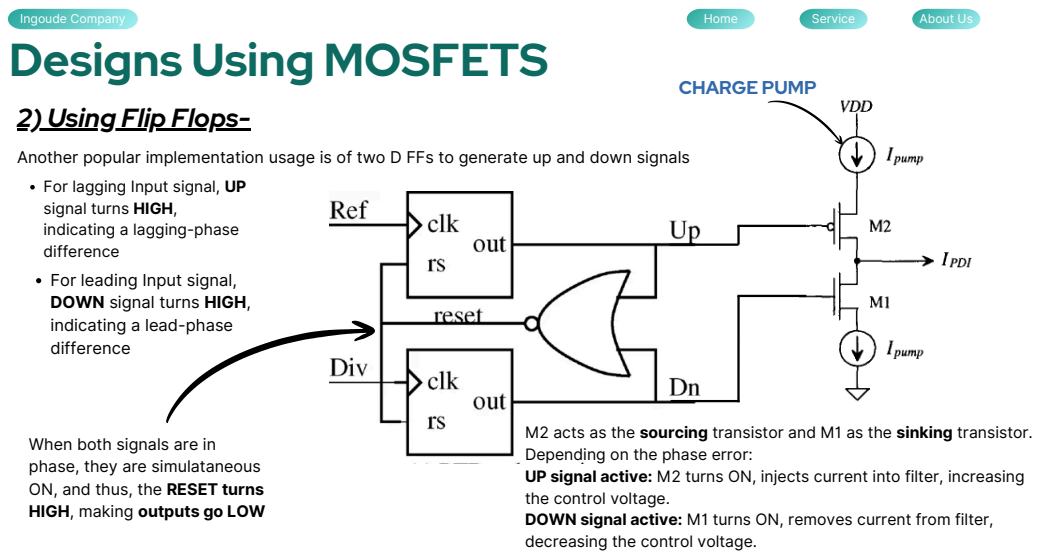
[picture p42: page 15]
CHARGE PUMP

Another popular implementation usage is of two D FFs to generate up and down signals
For lagging Input signal, UP
signal turns HIGH,
indicating a lagging-phase
difference
For leading Input signal,
DOWN signal turns HIGH,
indicating a lead-phase

M2 acts as the sourcing transistor and M1 as the sinking transistor.
Depending on the phase error:
UP signal active: M2 turns ON, injects current into filter, increasing
the control voltage.
DOWN signal active: M1 turns ON, removes current from filter,
decreasing the control voltage.

When both signals are in
phase, they are simulataneous
ON, and thus, the RESET turns
HIGH, making outputs go LOW

# Flip Flop Design (Contd..)

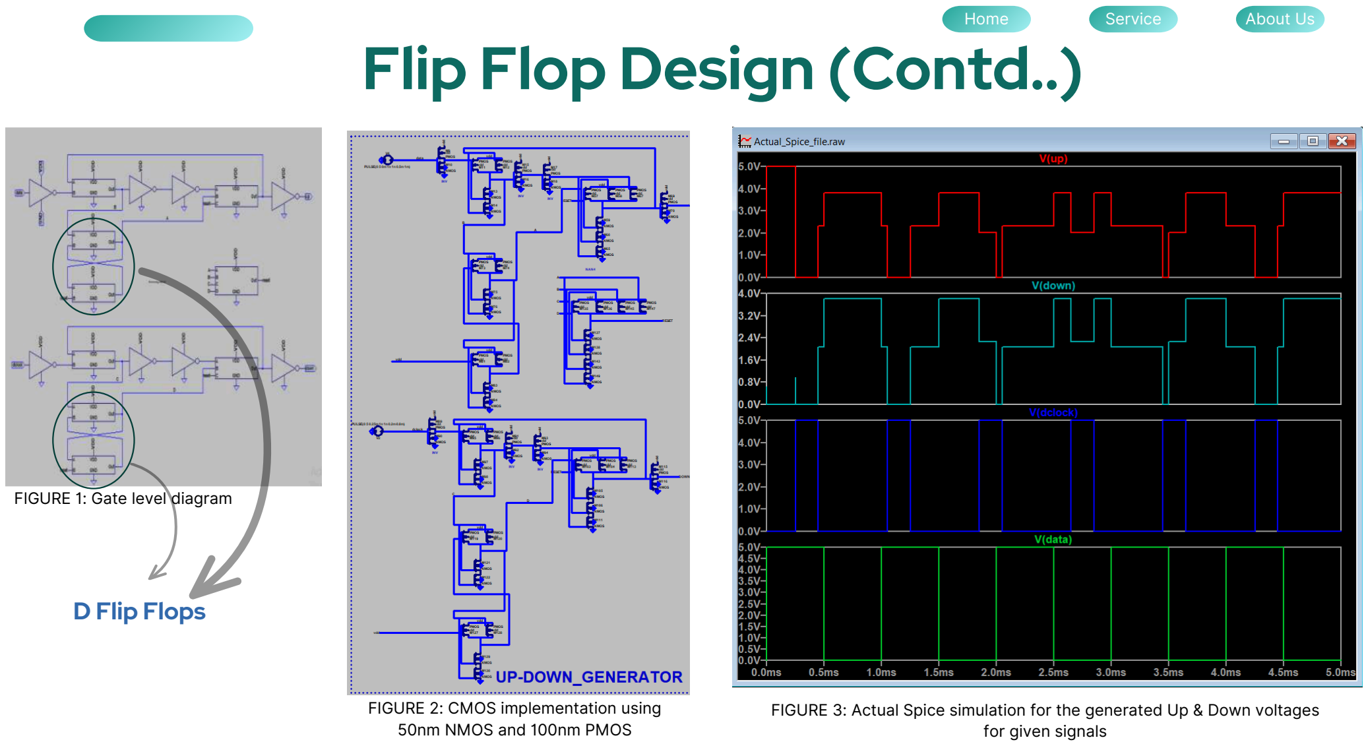
[picture p43: page 16]

Home | Service | About Us

FIGURE 3: Actual Spice simulation for the generated Up & Down voltages for given signals

## D Flip Flops

FIGURE 1: Gate level diagram

FIGURE 2: CMOS implementation using 50nm NMOS and 100nm PMOS

# Flip Flop Design (Contd..)

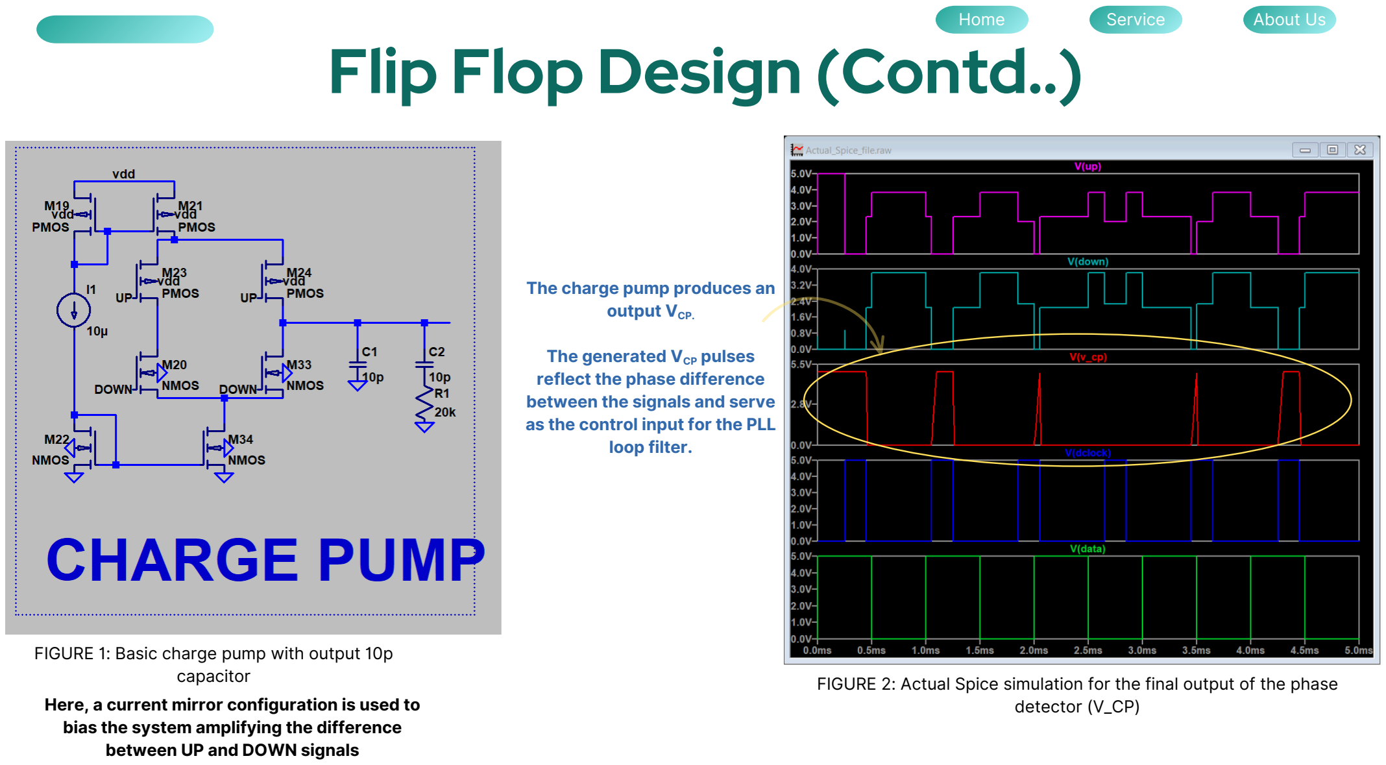
[picture p44: page 17]

Home | Service | About Us

FIGURE 2: Actual Spice simulation for the final output of the phase detector (V_CP)

FIGURE 1: Basic charge pump with output 10p capacitor
Here, a current mirror configuration is used to bias the system amplifying the difference between UP and DOWN signals

The charge pump produces an output VCP.

The generated V pulses
reflect the phase difference between the signals and serve as the control input for the PLL loop filter.

CP

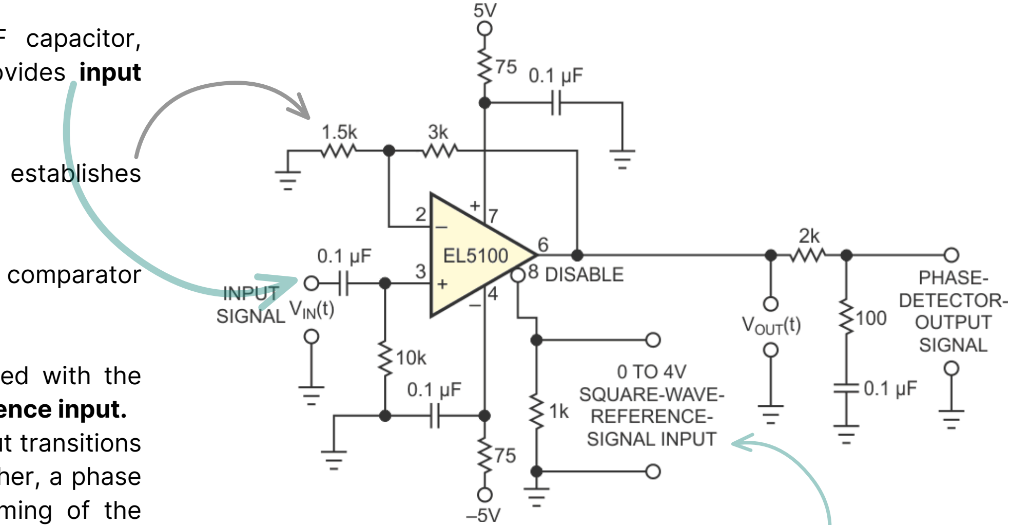
[picture p45: figure]

-The input signal is AC-coupled through the 0.1 μF capacitor,

### removing any DC offset, while the 10 kΩ resistor provides input

biasing.

### -The resistor network connected to the inverting input establishes

the comparator threshold voltage.

### -When the input signal crosses this threshold, the comparator

switches its output state.

### -The timing of these switching events is then compared with the

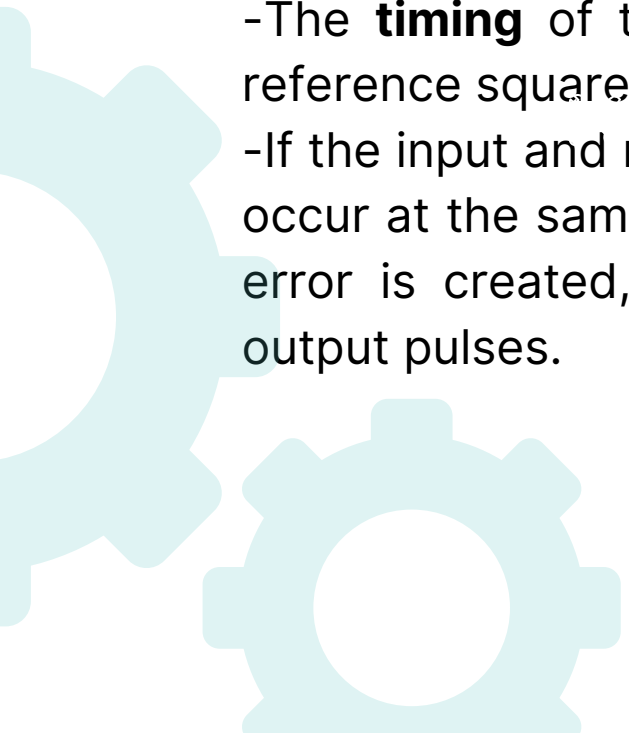
[picture p46: figure]
output pulses.

reference square wave applied to the comparator's reference input.

### -If the input and reference signals are in phase, the output transitions occur at the same time. If one signal leads or lags the other, a phase error is created, causing changes in the width and timing of the

# Designs Using Op-Amps (Phase Detector)

## THEORY

The ref signal at the disable input acts as a voltage control switch, i.e. only when it is HIGH does the output passes

# OpAmp based Phase Detector Design (SPICE)

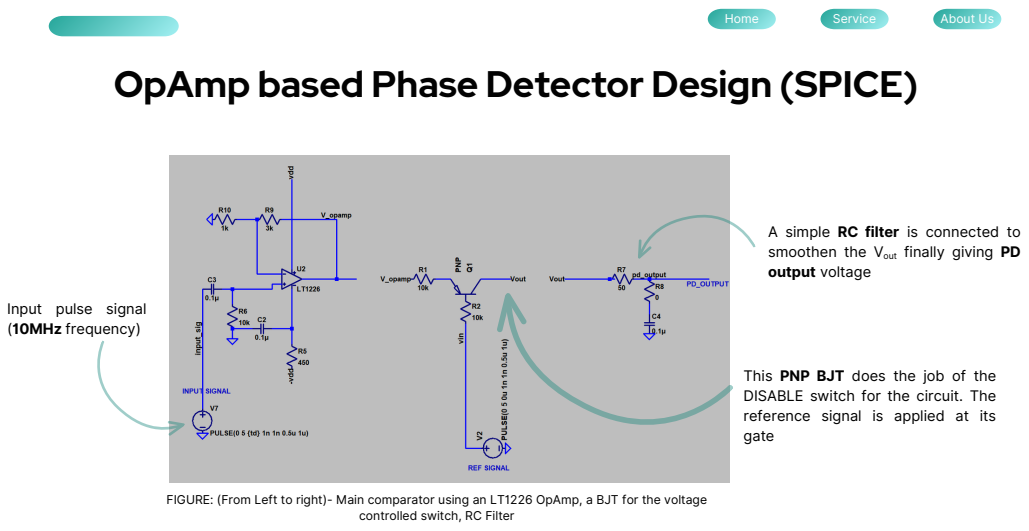
[picture p47: page 19]
Home; Service; About Us; out

A simple RC filter is connected to
smoothen the V finally giving PD
output voltage

Input pulse signal
(10MHz frequency)

This PNP BJT does the job of the
DISABLE switch for the circuit. The
reference signal is applied at its
gate

FIGURE: (From Left to right)- Main comparator using an LT1226 OpAmp, a BJT for the voltage

controlled switch, RC Filter

# OpAmp based Phase Detector Plots

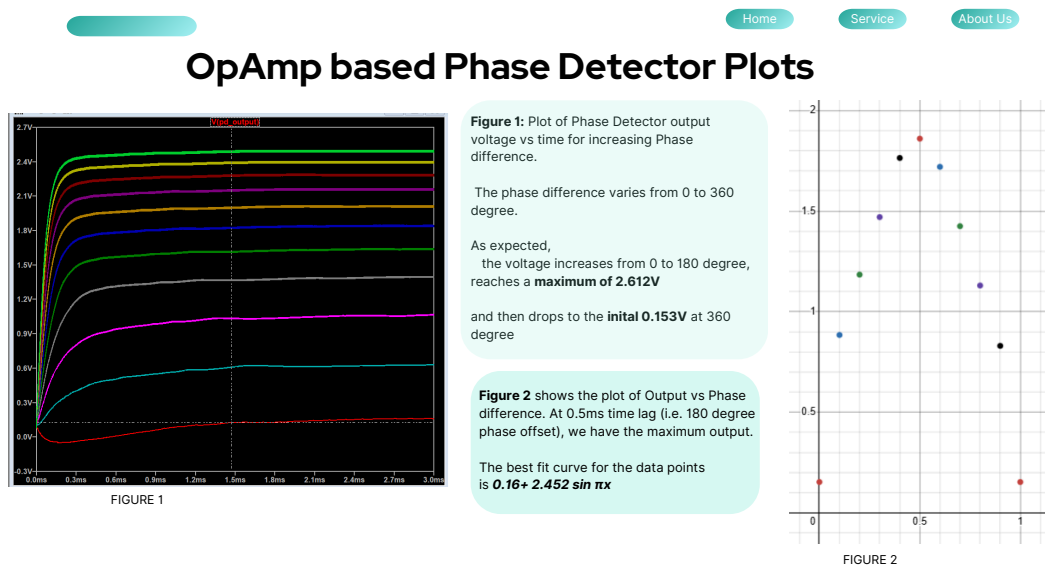
[picture p48: page 20]
Home; Service; About Us; FIGURE 2; FIGURE 1

Figure 1: Plot of Phase Detector output
voltage vs time for increasing Phase
difference.

The phase difference varies from 0 to 360
degree.

As expected,
the voltage increases from 0 to 180 degree,
reaches a maximum of 2.612V

and then drops to the inital 0.153V at 360
degree

Figure 2 shows the plot of Output vs Phase
difference. At 0.5ms time lag (i.e. 180 degree
phase offset), we have the maximum output.

The best fit curve for the data points
is 0.16+ 2.452 sin πx

# Designs Using Op-Amps (VCO)

## THEORY

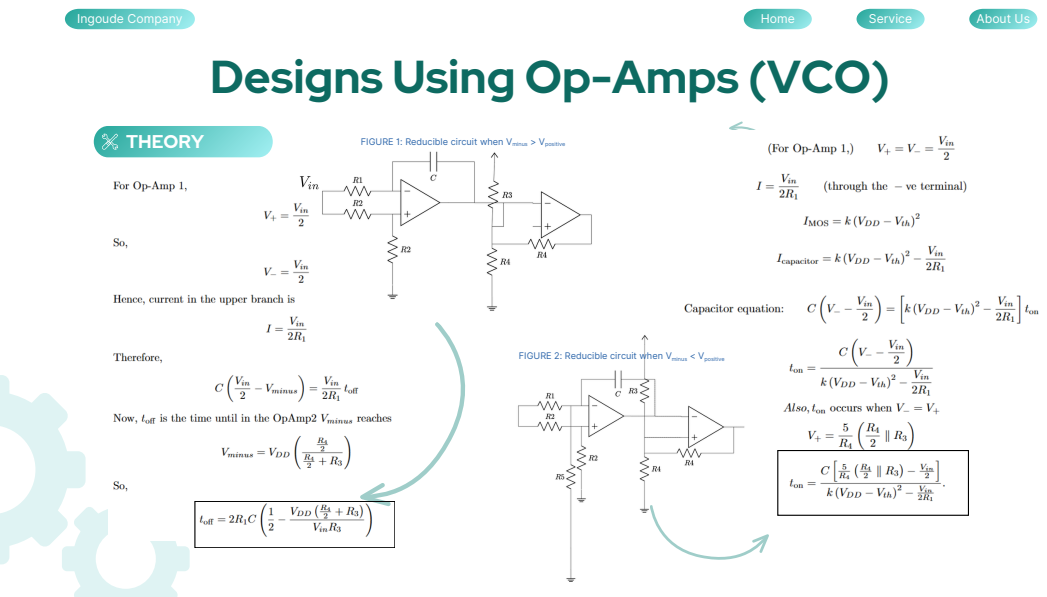
[picture p49: page 21]

FIGURE 1: Reducible circuit when Vminus > Vpositive

FIGURE 2: Reducible circuit when Vminus < Vpositive

# OpAmp based VCO Design

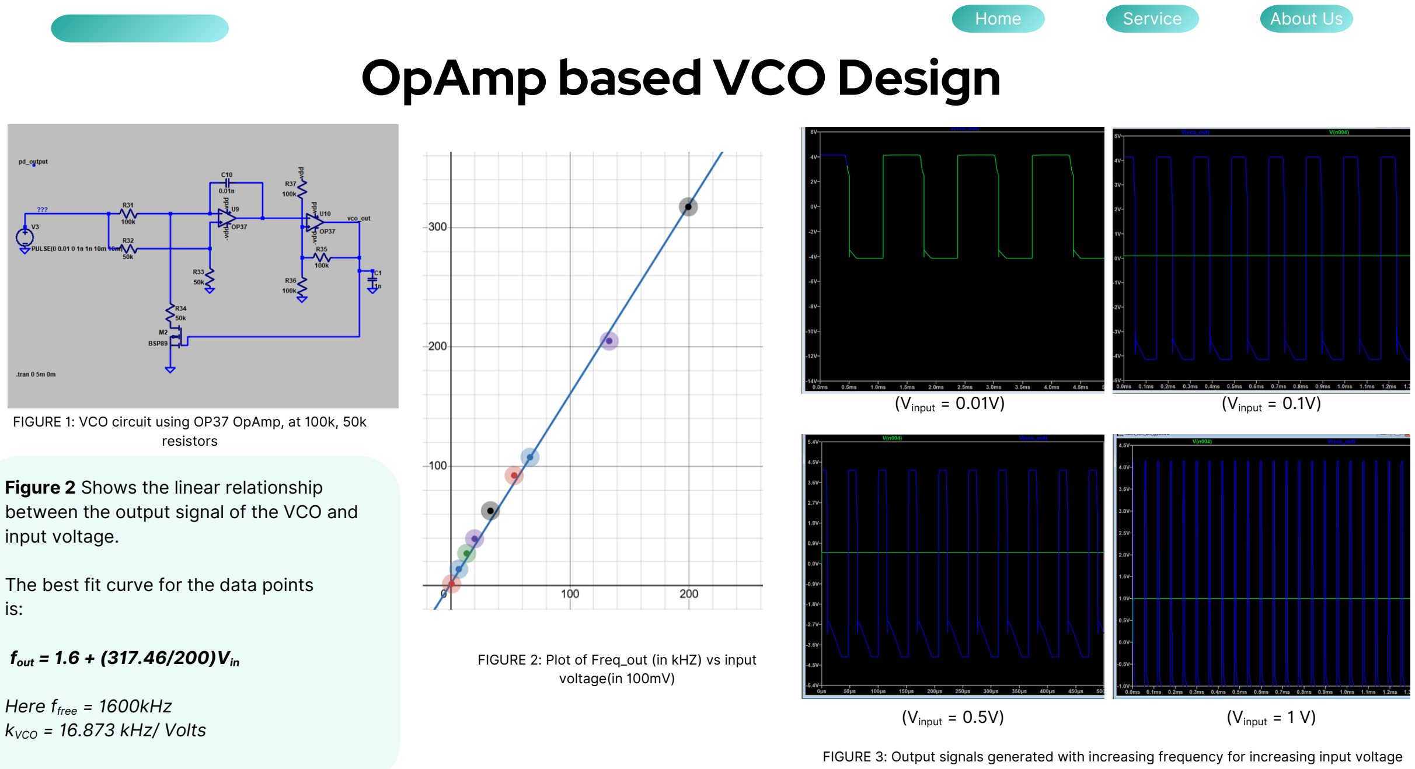
[picture p50: page 22]

FIGURE 1: VCO circuit using OP37 OpAmp, at 100k, 50k resistors

Home | Service | About Us
(Vinput = 0.01V) | (Vinput = 0.1V)
(Vinput = 0.5V) | (Vinput = 1 V)

FIGURE 2: Plot of Freq_out (in kHZ) vs input voltage(in 100mV)

Figure 2 Shows the linear relationship between the output signal of the VCO and input voltage.

The best fit curve for the data points
is:

fout = 1.6 + (317.46/200)Vin

Here ffree = 1600kHz
kVCO = 16.873 kHz/ Volts

FIGURE 3: Output signals generated with increasing frequency for increasing input voltage

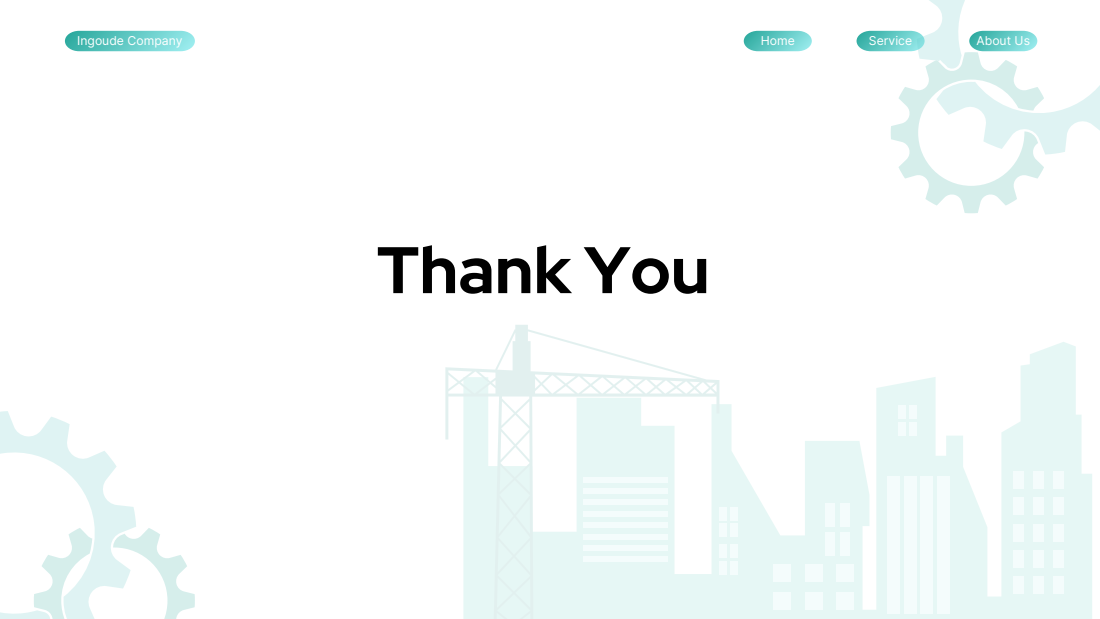
[picture p51: page 23]
Thank You
