Ironwin-15/PLL/PD_using_BJT/BJT_PD.asc

C1: cap; 1n
C2: cap; 100n
C3: cap; 100n
C4: cap; 1n
Q1: npn; BC547B
Q2: npn; BC547B
Q3: npn; BC547B
R1: res; 100k
R2: res; 1k
R3: res; 100k
R4: res; 10000000000
R5: res; 100k
R6: res; 100k
U1: UniversalOpAmp2; Avol=100Meg GBW=10Meg Slew=10Meg
V1: voltage; PULSE(0 5 0m 1n 1n 0.5m 1m)
V2: voltage; PULSE(0 5 0 1n 1n 0.5m 1m)
V3: voltage; PULSE(0 5 0 1n 1n 0.5m 1m)
V4: voltage; 5
V5: voltage; -5
V6: voltage; PULSE(0 5 0 1n 1n 0.5m 1m)
V7: voltage; PULSE(0 5 0m 1n 1n 0.5m 1m)
V8: voltage; PULSE(0 5 {t} 1n 1n 0.5m 1m)
V9: voltage; 2.5
Named nets: 0, vdd, -vdd, v2, v1, ref, inp
.tran 2s
.step param t 0 1m 0.1m
