Ironwin-15/PLL/PD_using_BJT/BOOST+SAWTOOTH.asc

2k: res; 10k
C1: cap; 10µ
C2: cap; 10n
D1: diode; 1N5819
D2: diode
D3: diode
L1: ind; 1200m
Q1: npn; BC547B
R1: res; 100
R2: res; 100k
R3: res; 100k
R4: res; 100k
R21: res; 24k
U1: UniversalOpAmp2
U2: UniversalOpAmp2
U3: UniversalOpAmp2
V1: voltage; 12; AC 12
V2: voltage; PULSE(0 5 0 1n 1n 0.55m 2m)
V3: voltage; PULSE(0 5 0 1n 1n 1 1)
V4: voltage; PULSE(0 -5 0 1n 1n 1 1)
V5: voltage; PULSE(0 0 0 1n 1n 1 1)
V8: voltage; -5
V9: voltage; 5
Named nets: 0, PWM, Gate, Capacitor, vdd, -vdd, v, -v, i
.tran 3000m
.ac dec 10 1 50k
VCO_INPUT
DUTY CYCLE GENERATOR
BOOST CONVERTER
.tran 1000m startup
